MB3hel/AUVControlBoard/docs/docs/user_guide/general_use.md

# Using Control Board

TODO

- General Procedure
    - Connecting to Control Board
    - System configuration (motor matrix, thruster inversions)
    - Sensor configuration
    - Validating sensor connectivity
    - Modes of operation & setting speed
    - Motor Watchdog
    - Reading Sensor data
    - Example program using python interface script
- LED Indicator Info
