MB3hel/AUVControlBoard/docs/docs/user_guide/preparing_board.md

# Preparing a Control Board

TODO:

- Flashing firmware
- Wiring
- Testing USB
