MB3hel/AUVControlBoard/docs/docs/firmware/math_res/construct_orientation_errors.png

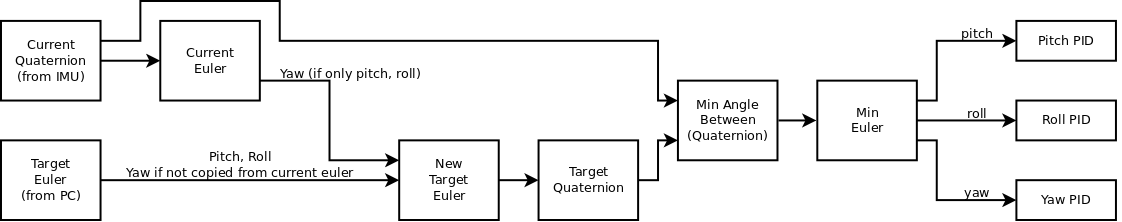
docs/docs/firmware/math_res/construct_orientation_errors.png
