MB3hel/AUVControlBoard/(threads)

Thread 3 (2022-12-10):

Several vars missing static in motor_control

MB3hel, 2022-12-10:
- motor_wdog_timeout function
- Motor wdog timer
- semaphore handle

Closed 2022-12-28.

Thread 8 (2022-12-23):

[FEATURE] Sensor calibration

MB3hel, 2022-12-23:
IMU:

- Ability to calibrate IMU, read calibration registers, store that persistently on a single device, and write the calibration registers on each startup.
- Would also likely need a way to read calibration status of each sensor.
- The BNO055 may be able to save a calibration profile? Need to check datasheet.

Depth sensor:

- Ability to indicate a "surface" reading as "zero" depth. Ideally also could be stored and re-applied on each startup (not on the depth sensor itself, but in firmware).
- Ability to change surface atmospheric pressure and fluid density constants directly

MB3hel, 2023-04-09:
IMU calibration would provide minimal / no benefit for the 6DOF fusion mode used by control board. Thus, only considering depth sensor.

MB3hel, 2023-06-28:
Now WIP on `feature/imucal` branch. Using emulated eeprom to store calibration data (see `feature/emueeprom`).

MB3hel, 2023-06-29:
Fully implemented on `feature/sensorcal`

Closed 2023-06-29.

Thread 10 (2023-01-02):

[FEATURE] Raw IMU data

MB3hel, 2023-01-02:
Add raw BNO055 data read command for debug purposes. Both gyro and accel rates (x, y, z).

MB3hel, 2023-04-09:
No longer planned. Not really any use case. Can just read quaternions to get debug data. Can re-evaluate if a real use case is found.

Closed 2023-04-09.

Thread 12 (2023-01-05):

[BUG] No serial number in usb descriptors for v2

MB3hel, 2023-01-05:
**Describe the bug**
Version 2 has no serial number via USB.

**Tested Versions**
v1, v2

**Impacted Versions**
v2

**To Reproduce**
Connect usb device. Read info. Observe no valid serial number.

**Expected behavior**
Usb would report STM32 chip serial number.

**Additional context**
Serial number for string descriptor not implemented in usb descriptor code for v2.

Closed 2023-01-08.

Thread 13 (2023-01-07):

[BUG] cmdctrl target changes not atomic

MB3hel, 2023-01-07:
cmdctrl can change target when processing pc command, however timer thread is used to re-apply saved speed. Following sequence of operations needs to be impossible (but is not)

- periodic reapply (timer thread) reads the current target
- cmdctrl thread handles a speed set message and changes current target and/or mode
- cmdctrl thread sets new speed
- periodic reapply (timer thread) sets the target it previously read (now wrong target)

Sequence of accessing current mode & saved target speeds then setting speeds needs to be protected by mutex.

Thread 14 (2023-01-14):

[FEATURE] Better failure state behavior

MB3hel, 2023-01-14:
Failure state should write some persistent memory with cause (eg stack overflow) and reset the board instead of just deadlocking forever.

MB3hel, 2023-04-01:
Reset cause is now stored between soft resets on both boards. Can be queried using a command or with interface `whyreset.py` script (`./launch.py whyreset.py -p /dev/ttyACM1`)

Closed 2023-04-01.

Thread 15 (2023-01-15):

[FEATURE REQUEST] Implement watchdog timer

MB3hel, 2023-01-15:
**Is your feature request related to a problem? Please describe.**
Deadlocks can occur in the current firmware (either full deadlocks or single threads blocking forever)

**Describe the solution you'd like**
As a worst case, would be good for board to reset in these cases

Closed 2023-01-27.

Thread 16 (2023-01-15):

[BUG] Command processing fails due to I2C lockup

MB3hel, 2023-01-15:
**Describe the bug**
An I2C lockup is possible on v1 due to some oddities in the hardware state machine for I2C SERCOMs. This lockup results in I2C operations seeming to start correctly, but no interrupt ever occurs indicating a finished operation (no complete, no error, etc). This is a "silent" failure as far as software is concerned.

When this occurs, the i2c perform function will own the mutex and wait for the semaphore, however the semaphore will never be given by the interrupt callback function (as it never happens). This leads to the mutex being held forever.

This often occurs first on the sensor data threads, causing sensor data to stop working. However, an IMU set axis command will cause the cmdctrl thread to attempt an i2c operation. This results in the cmdctrl thread blocking forever.

**Tested Versions**
v1, v2

**Impacted Versions**
v1

**To Reproduce**
Steps to reproduce the behavior (INCLUDE WHAT BUILD CONFIGURATION USED):
1. Run the firmware (debug and release tested)
2. Launch the sensordata interface script
3. Tapidly tap the i2c pins on the BNO055 or the ItsyBitsy with your dry finger (this only accelerates the "failure" but it occurs sometimes without external noise). Repeat until sensor data is not acquired from board anymore (as seen in script output)
4. Kill and re-launch the sensordata script. This causes an imu axis config command
5. Any other commands will timeout since the cmdctrl thread is blocked. A debugger can be used to see the usb thread working properly, but the notification is never serviced (due to thread being blocked).

**Expected behavior**
- I2C "silent failure" should be detected by a timeout waiting for the semaphore. The only way I have found to fix the state is to disable then re-enable the SERCOM
- Waiting on the I2C mutex for i2c_perform should have a timeout. If it times out acquiring the mutex, consider the operation to have failed.
- A watchdog timer should be used to reset the system if cmdctrl can not run for too long (related to #15)

MB3hel, 2023-01-16:
Further investigation indicates that a bus error state may be indicated via the error interrupt when the bad state is entered. Thus, this may be detected without just using a timeout.

Closed 2023-01-16.

Thread 17 (2023-01-15):

[BUG] Sensor data stops being acquired

MB3hel, 2023-01-15:
**Describe the bug**
After some time, sensor data stops being acquired (both I2C sensors).

**Tested Versions**
v1, v2

**Impacted Versions**
v2 (v1 impacted by a different bug with similar effect; see #16)

**To Reproduce**
Steps to reproduce the behavior (INCLUDE WHAT BUILD CONFIGURATION USED):
1. Run the firmware (debug and release tested)
2. Leave it running for a while.
3. See sensor data stop (usually after 30ish minutes)

**Expected behavior**
Sensors don't stop working or if they do, they are recovered.

**Additional context**
I speculate that something happens and a sensor is holding sda low. More investigation is needed using debugger to determine if i2c operations are failing. Scope could also help see if sda is held low.

MB3hel, 2023-01-18:
This is basically the same thing as #16, but the way it impacts v2 is different.

Noise on the bus makes the peripheral thing another device (master) is using the bus. This makes the hardware enter a "BUSY" state (status bit for STM32F4). This usually means another master is using the bus, however there is no other master. Thus if this happens, it should be assumed to be noise (or sensor hotplug) induced. Thus, the firmware needs to recover from this state.

Closed 2023-01-18.

Thread 18 (2023-01-18):

[BUG] Sensor Data is sometimes all zero

MB3hel, 2023-01-18:
**Describe the bug**
Sometimes, when running the `sensordata.py` script, the data is all zeros. Re-launching the script seems to fix the error. This certainly happens with the IMU. I don't recall if it also impacts the depth sensor when this occurs.

My current theory is that the axis configure is somehow related since re-launching the script fixes the issue. That is really the only major config change that re-launching the script would cause.

**Tested Versions**
v1, v2

**Impacted Versions**
v1, v2

**To Reproduce**
Steps to reproduce the behavior (INCLUDE WHAT BUILD CONFIGURATION USED):
1. Build Debug for v1 or v2 (other build configs not tested)
2. Flash the board
3. Run the `sensordata.py` script
4. See if IMU data is all zeros. If not, re-launch sensordata script until it is.

**Expected behavior**
IMU data is not zero

MB3hel, 2023-01-18:
Likely fixed by 771118a5e1df272cff5b6d278051f65121fe0f7c. Will do some more testing and close if no longer reproducible.

MB3hel, 2023-01-27:
Has occurred again despite this change. Other options need to be explored.

MB3hel, 2023-06-29:
This was likely caused by a race condition for using the bno055's i2c_transaction instance. During axis configuration both the cmdctrl thread and the bno055 thread could simultaneously alter the transaction (only the i2c perform was mutexed).

This has been fixed on `feature/sensorcal` and should not be a problem in the next release.

Closed 2023-06-29.

Thread 19 (2023-01-18):

[FEATURE REQUEST] Reset command

MB3hel, 2023-01-18:
**Is your feature request related to a problem? Please describe.**
Some bugs can be worked around by system reset (eg some recent i2c issues). Currently, a power cycle is required.

**Describe the solution you'd like**
Add a command (via USB) to trigger a system reset (likely via watchdog; depends on #15)

**Describe alternatives you've considered**
N/A

**Additional context**
N/A

Closed 2023-01-27.

Thread 20 (2023-02-20):

[BUG] Speed sets on v1 may fail silently

MB3hel, 2023-02-20:
**Describe the bug**
If the `TCCx_PWM24bitDutySet` function returns false, the `thruster_set` function will not retry or do anything about this. In this case, the thruster speed set seems to succeed, but will not have necessarily.

**Tested Versions**
v1

**Impacted Versions**
v1

**Expected behavior**
`thruster_set` should handle this function returning false by retrying the speed set (maybe with a small delay).

**Additional context**

This **could** explain an issue happening AquaPack Java code for using control board missing some speed sets in RAW mode. The testing scenario this occurred in:

- Java code running on Orange Pi 4 LTS
- Java code runs motors one after the other at a fixed speed for a fixed time
- Before each motor is run, a TINV command is sent without waiting for ACK before sending the RAW command
- Control Board v1 unit in use running Release build firmware

The theory is that TINV (triggering an apply_saved_speed) followed by a RAW command already in the buffer may happen fast enough that the PWM set function returns false.

This is consistent with the observations that introducing debug messages into `thruster_set` (debug build) makes this issue no longer occur compared to a release build without any such messages.

The missing of thruster speed sets did not occur every time nor did it occur consistently when it did happen.

This would also explain why the interface scripts work (they do not TINV before RAW so there are not two back to back speed sets happening in the firmware).

TLDR: (theory)

Computer:

- Computer writes TINV (ack not waited for)
- Computer writes RAW (probably at the same time as TINV written due to buffering)
- Control board handles TINV causing a speed set of the saved raw mode target
- Control board handles RAW immediately (already in buffer)
- This causes a second speed set too fast and the pwm set function returns false (not handled)
- Control board acknowledges speed set with no error
- Computer is informed that speeds were set, but some thrusters may not respond sometimes.

Closed 2023-02-21.

Thread 21 (2023-03-27):

[BUG] Reboot to bootloader does not work on v2 with release builds

MB3hel, 2023-03-27:
**Describe the bug**
Triggering a reboot to bootloader using the `reboot_bootoader.py` script works with v2 as expected for debug builds, but fails on release builds.

**Tested Versions**
v1, v2

**Impacted Versions**
v2

**To Reproduce**
1. Build v2 release and flash
2. Run `reboot_bootloader.py` with the correct port
3. The device resets twice, but does not enter bootloader

**Expected behavior**
After the second reset, device should enter bootloader.

Closed 2023-04-01.

Thread 22 (2023-03-31):

[BUG] Reset with newer firmware

MB3hel, 2023-03-31:
**Describe the bug**
- Watchdog triggers system reset unexpectedly when using sassist.py and sensordata.py (release build, v1)
- When using a debug build (debug build, v1) it deadlocks
- Impacts v2 as well (tested with release build, v2 = causes reset)

**Tested Versions**
v1, v2

**Impacted Versions**
v1, v2

**To Reproduce**
1. Build release for v1 or v2
2. Run the `sensordata.py` script
3. Run the `sassist.py` script
4. Wait a few seconds
5. Hit enter to end `sassist.py`
6. Repeat steps 2-5 until the system resets (indicated by LED going back to yellow = RAW mode)

**Expected behavior**
No system reset; deadlock does not occur.

MB3hel, 2023-03-31:
Deadlocks due to `mval` being `nan` causing this to be an infinite loop. Not sure why this becomes nan. Located in `motor_control.c` in `mc_set_local`
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

MB3hel, 2023-03-31:
Caused by check failure in `cmdctrl.c`'s `cmdctrl_apply_saved_speed`. If the IMU data returns zero (as it does after axis configure), this is passed to `mc_set_global`. The newer implementation of `mc_set_global` will result in `nan`s being passed to `mc_set_local` in this scenario due to the invalid quaternion.

This is fixed by checking valid sensor data in `cmdctrl_apply_saved_speed` before calling `mc_set_global`, `mc_set_sassist`, or `mc_set_dhold`

Closed 2023-03-31.

Thread 23 (2023-04-09):

[FEATURE] Change Sensor models to names in messages

MB3hel, 2023-04-09:
BNO055 -> IMU
MS5837 -> DEPTH

MB3hel, 2023-06-29:
Given the existing stable release, there are no longer plans to do this.

Closed 2023-06-29.

Thread 24 (2023-04-10):

[BUG] Sending commands too fast crashes control board

MB3hel, 2023-04-10:
**Describe the bug**
Sending SASSIST1 messages too fast will cause the control board to deadlock and a watchdog reset to occur.

**Tested Versions**
v1, v2

**Impacted Versions**
v1, v2

**To Reproduce**
1. Flash Release Build (v1) (also impacts debug builds, but does not cause reset since WDT disabled for debug)
2. Send SASSIST1 messages as fast as possible (don't wait for ACK)
3. Wait until serial communication drops
4. Check reset cause using `./launch.py whyreset`. It will be `-6`.

**Expected behavior**
No deadlock or reset occurs

MB3hel, 2023-04-10:
Note that sometimes it is required to disable waiting for ACK on SASSIST1 messages to reproduce this.

MB3hel, 2023-04-10:
Can also be reproduced using python interface, which does wait for acknowledgement

`test.py`
```py
#!/usr/bin/env python3

from control_board import ControlBoard, Simulator
import random
import time

def run(cb: ControlBoard, s: Simulator) -> int:
    res, imu, depth = cb.get_sensor_status()
    if(res == cb.AckError.NONE):
        print("Done")
    else:
        print("Fail")
        return 1
    if imu == False or depth == False:
        print("Missing sensor(s).")
        return 1
    cb.tune_sassist_pitch(4.0, 0.0, 0.0, 1.0, False)
    cb.tune_sassist_roll(4.0, 0.0, 0.0, 1.0, False)
    cb.tune_sassist_yaw(4.0, 0.0, 0.0, 1.0, False)
    cb.tune_sassist_depth(4.0, 0.0, 0.0, 1.0, False)
    while True:
        depth = random.randint(-100, -1)
        depth /= 10.0
        cb.set_sassist1(0.0, 0.0, 0.0, 0.0, 0.0, depth)
```

MB3hel, 2023-04-10:
From debug build (which takes much longer to trigger the issue), it seems to end up on line 168 of `thirdparty/FreeRTOS/list.c`. This has a lovely note...

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

And the following call stack
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

MB3hel, 2023-04-10:
This can also be triggered with a global mode set or local mode set. Also with non-speed set commands such as sensor status queries.

MB3hel, 2023-04-10:
Seems to be caused by use of critical section in `pccomm_write`. Replaced with mutex. On `fix_fast_msg` branch.

Closed 2023-04-10.

Thread 26 (2023-04-19):

[FEATURE] Accumulated euler angles in sim hijack without BNO055

MB3hel, 2023-04-19:
Simulator hijack without a BNO055 doesn't accumulate euler angles. Would probably be best to split BNO055 and MS5837 data processing (`sensor_process(data...)`). The read function would call process. Cmdctrl would call process when receiving sim data.

MB3hel, 2023-05-12:
Fixed differently.

Thread 27 (2023-06-11):

[BUG] Incorrect Motor Motions after running for a long time

MB3hel, 2023-06-11:
**Describe the bug**
After leaving the device running for several hours (somewhere between 2-5 hours) the control board started generating incorrect motor signals. During the several hours the device was running, various commands were sent to the device and the vehicle was in motion using various modes.

When the issue occurred, thrusters would not complete arming (usually; sometimes a few would). This was determined by the last "beep" that indicates a zero speed is currently applied to the ESC by PWM signal. Additionally, when trying to run a motor test, various unexpected motions occurred (details of what specific motions were are unknown).

**Tested Versions**
v1

**Impacted Versions**
v1

**To Reproduce**
1. Run for a long time
2. Check PWM signals
3. Observe any issues

**Expected behavior**
1500us pulse for zero speed

MB3hel, 2023-06-28:
I have been unable to reproduce this as of now. More info is needed to track down this issue.

Thread 28 (2023-11-07):

[BUG] Crash on NaN Motor Speeds

Bennett-Petzold, 2023-11-07:
**Describe the bug**
Sending NaN as a motor speed causes a reset with code -6.

**Tested Versions**
v1 and v2

**Impacted Versions**
v1 and v2

**To Reproduce**
Send a stability_assist_2 command with a NaN as the x value.

**Expected behavior**
Some non-crash behavior, likely a rejection of the message.

**Additional context**
The code crashes because it gets stuck in a loop.

MB3hel, 2023-11-25:
Now fixed on main. Will be in next 1.1.0 release.

When sending nan, inf, or other out of range values, the command is **not** rejected. The control board fores values into the valid range for arguments. In the case of nan or inf, they will be treated as zeros. This is consistent with the behavior described in the docs.

While it may be useful in this specific case to have out of range values be rejected with an "INVALID_ARG" error, this error is primarily intended to mean "incorrect number of arguments". Furthermore, rejecting out of range value with INVALID_ARG could cause other problems. For example, if the code sending speeds to the control board calculates 1.05 instead of 1.00 due to floating point errors, it would be undesirable for control board to reject the command. As such, out of range values are (by design) forced into range by the control board.

It is recommended to have value checks (for nan, inf, values with magnitudes much larger than 1, etc) in code using the control board (the code issuing commands). This can allow warnings to be logged if invalid values are generated before sending to the control board.

Closed 2023-11-25.
