MB3hel/AUVControlBoard/pcb/PCBv2.1/PCBv2.1.kicad_sch

## KiCad design pcb/PCBv2.1/PCBv2.1.kicad_sch (2023-04-08, an earlier design)

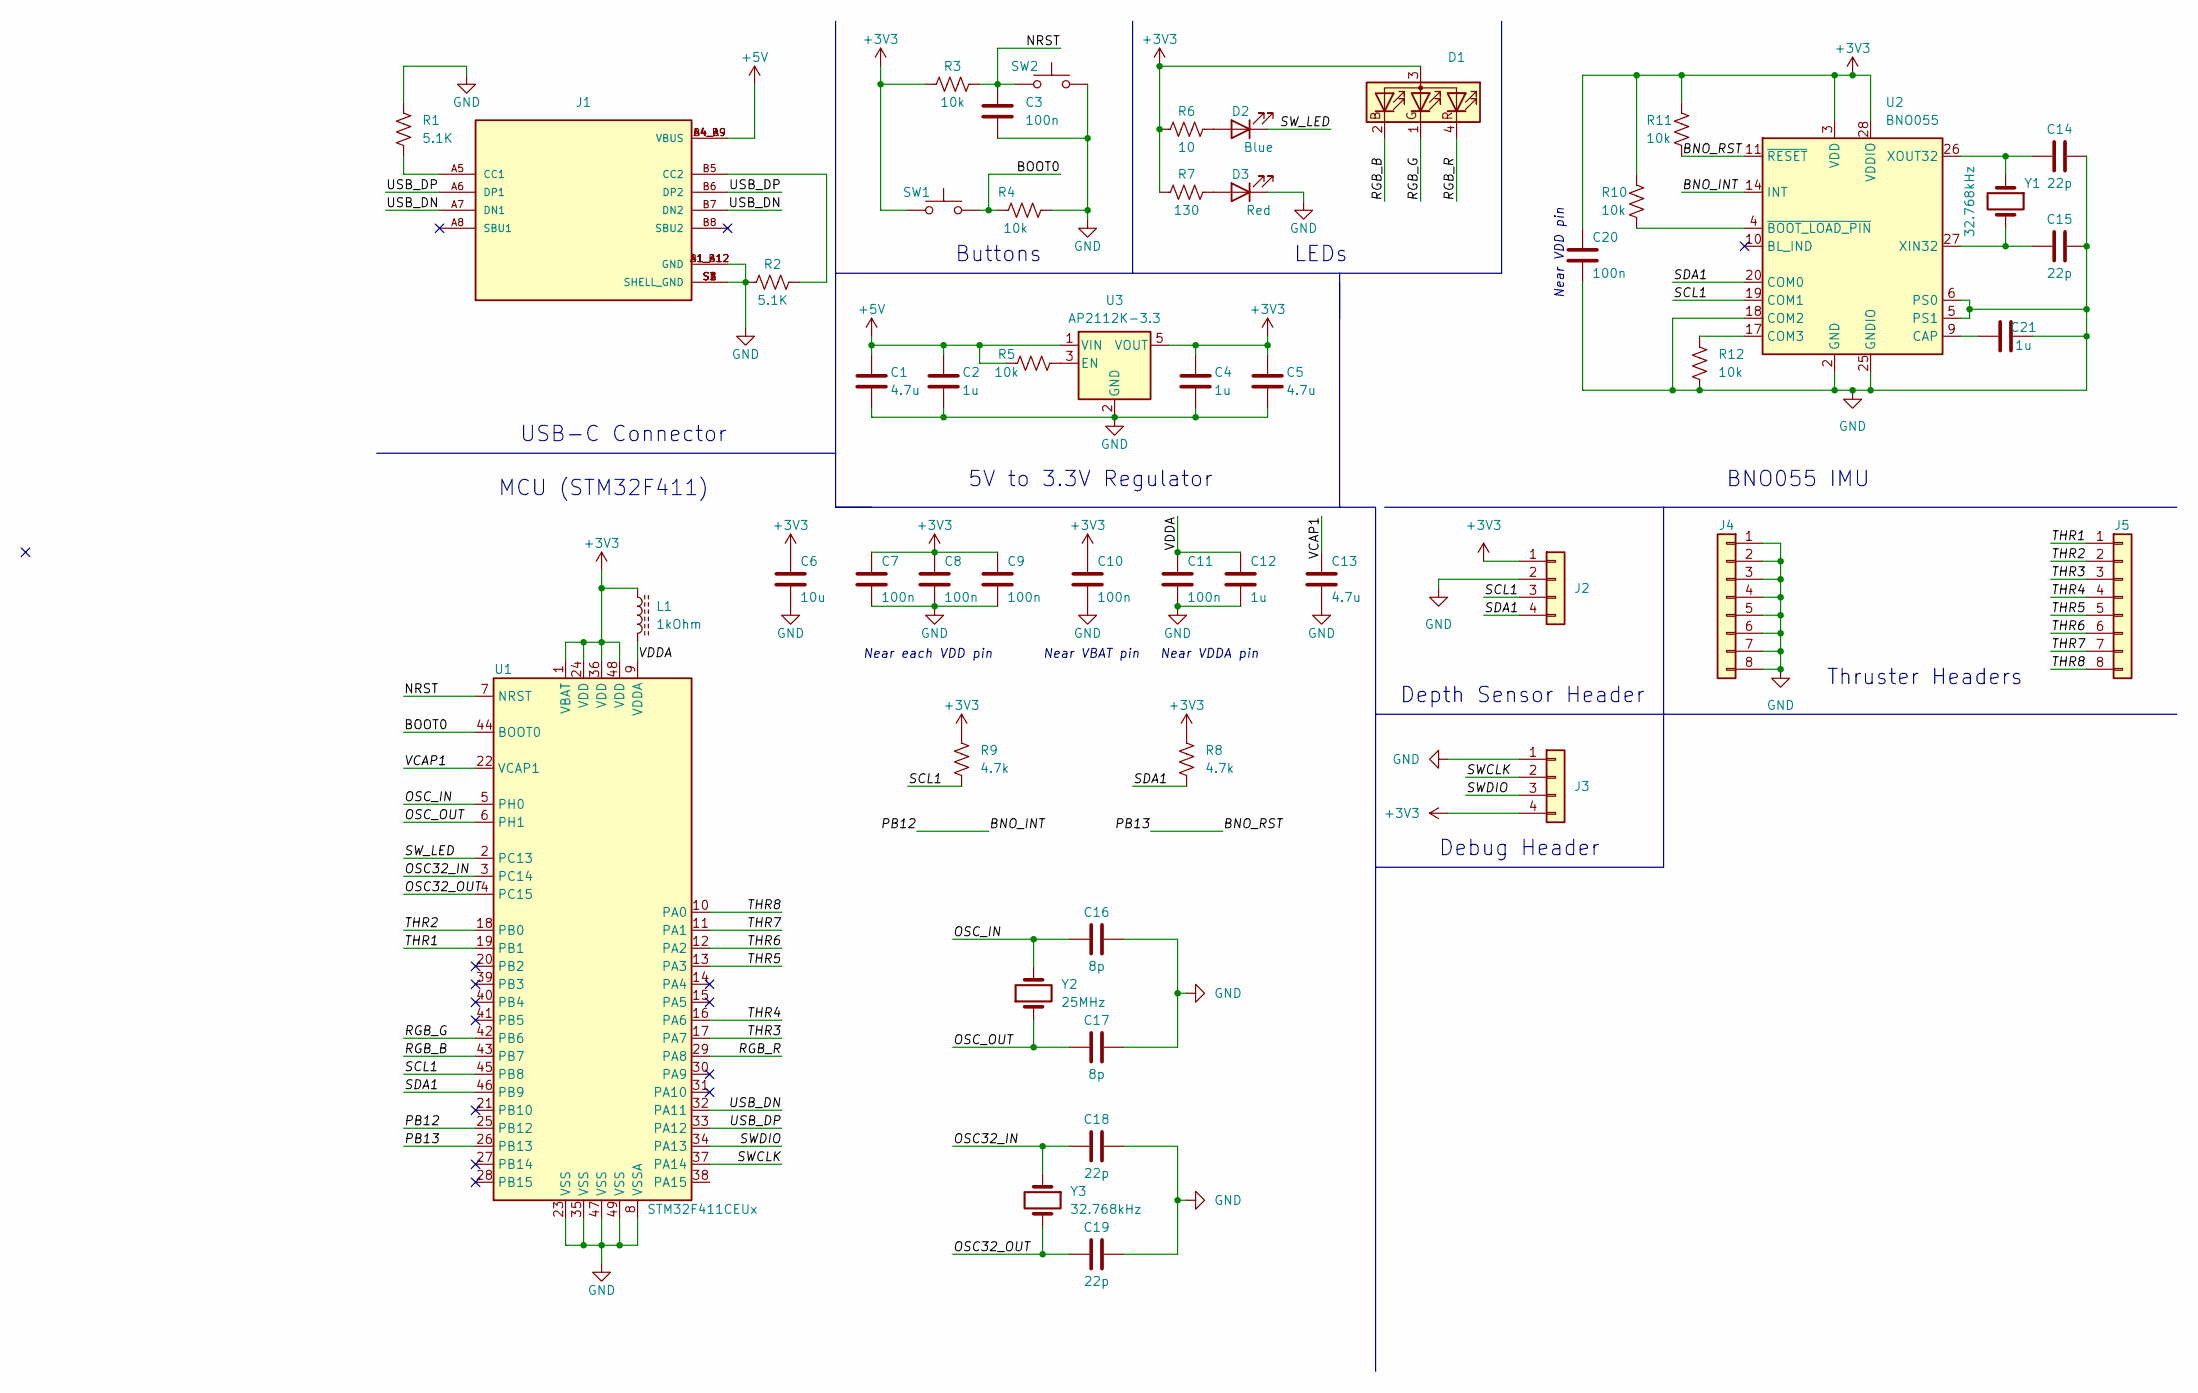
[picture p31: schematic PCBv2.1.kicad_sch]

Parts:
C1, C5, C13: 4.7u; C_0805_2012Metric_Pad1.18x1.45mm_HandSolder; Part Number GRM21BC71E475KE11L
C2, C4, C12, C21: 1u; C_0805_2012Metric_Pad1.18x1.45mm_HandSolder; Part Number GCJ21BC72A105KE02L
C3, C7, C8, C9, C10, C11, C20: 100n; C_0805_2012Metric_Pad1.18x1.45mm_HandSolder; Part Number GCM21BR71E104JA37L
C6: 10u; C_0805_2012Metric_Pad1.18x1.45mm_HandSolder; Part Number GRT21BC71E106KE13L
C14, C15, C18, C19: 22p; C_0805_2012Metric_Pad1.18x1.45mm_HandSolder; Part Number GRM21A5C2E220FW01D
C16, C17: 8p; C_0805_2012Metric_Pad1.18x1.45mm_HandSolder; Part Number GQM2195C2E8R0CB12D
D1: LED_RGBA; LED_D5.0mm-4_RGB; Part Number QBL8RGB60D0-2897
D2: Blue; LED_0805_2012Metric_Pad1.15x1.40mm_HandSolder; Part Number 150080BS75000
D3: Red; LED_0805_2012Metric_Pad1.15x1.40mm_HandSolder; Part Number 150080RS75000
J1: USB4105-GF-A; GCT_USB4105-GF-A; Part Number USB4105-GF-A
J2, J3: Conn_01x04; PinHeader_1x04_P2.54mm_Vertical
J4, J5: Conn_01x08; PinHeader_1x08_P2.54mm_Vertical
L1: 1kOhm; L_0805_2012Metric_Pad1.05x1.20mm_HandSolder; Part Number MFBM1V2012-102-R
R1, R2: 5.1K; R_0805_2012Metric_Pad1.20x1.40mm_HandSolder; Part Number ERJ-HP6F5101V
R3, R4, R5, R10, R11, R12: 10k; R_0805_2012Metric_Pad1.20x1.40mm_HandSolder; Part Number ERJ-6ENF1002V
R6: 10; R_0805_2012Metric_Pad1.20x1.40mm_HandSolder; Part Number ERJ-6ENF10R0V
R7: 130; R_0805_2012Metric_Pad1.20x1.40mm_HandSolder; Part Number ERJ-P06F1300V
R8, R9: 4.7k; R_0805_2012Metric_Pad1.20x1.40mm_HandSolder; Part Number ERJ-6ENF4701V
SW1, SW2: SW_Push
U1: STM32F411CEUx; QFN-48-1EP_7x7mm_P0.5mm_EP5.6x5.6mm; Part Number STM32F411CEU6
U2: BNO055; LGA-28_5.2x3.8mm_P0.5mm; Part Number BNO055
U3: AP2112K-3.3; SOT-23-5; Part Number AP2112K-3.3
Y1, Y3: 32.768kHz; Part Number ABS25-32.768KHZ-T
Y2: 25MHz; Part Number NX2016SA-25.000M-STD-CZS-1

Connections:
+3V3: C4.1, C5.1, C6.1, C7.1, C8.1, C9.1, C10.1, C20.1, D1.3 (A), J2.1, J3.4, L1.1, R3.1, R6.1, R7.1, R8.1, R9.1, R10.1, R11.1, SW1.1, U1.1 (VBAT), U1.24 (VDD), U1.36 (VDD), U1.48 (VDD), U2.3 (VDD), U2.28 (VDDIO), U3.5 (VOUT)
+5V: C1.1, C2.1, J1.A4_B9 (VBUS), J1.B4_A9 (VBUS), R5.1, U3.1 (VIN)
BNO_INT: U1.25 (PB12), U2.14 (INT)
BNO_RST: R11.2, U1.26 (PB13), U2.11 (~RESET)
BOOT0: R4.1, SW1.2, U1.44 (BOOT0)
GND: C1.2, C2.2, C3.2, C4.2, C5.2, C6.2, C7.2, C8.2, C9.2, C10.2, C11.2, C12.2, C13.2, C14.2, C15.2, C16.2, C17.2, C18.2, C19.2, C20.2, C21.2, D3.1 (K), J1.A1_B12 (GND), J1.B1_A12 (GND), J1.S1 (SHELL_GND), J1.S2 (SHELL_GND), J1.S3 (SHELL_GND), J1.S4 (SHELL_GND), J2.2, J3.1, J4.1, J4.2, J4.3, J4.4, J4.5, J4.6, J4.7, J4.8, R1.1, R2.1, R4.2, R12.2, SW2.2, U1.8 (VSSA), U1.23 (VSS), U1.35 (VSS), U1.47 (VSS), U1.49 (VSS), U2.2 (GND), U2.5 (PS1), U2.6 (PS0), U2.15 (GNDIO), U2.16 (GNDIO), U2.18 (COM2), U2.25 (GNDIO), U3.2 (GND)
NRST: C3.1, R3.2, SW2.1, U1.7 (NRST)
unnamed: C14.1, U2.26 (XOUT32), Y1.1
unnamed: C15.1, U2.27 (XIN32), Y1.2
unnamed: C21.1, U2.9 (CAP)
unnamed: D2.2 (A), R6.2
unnamed: D3.2 (A), R7.2
unnamed: J1.A5 (CC1), R1.2
unnamed: J1.B5 (CC2), R2.2
unnamed: R5.2, U3.3 (EN)
unnamed: R10.2, U2.4 (~BOOT_LOAD_PIN)
unnamed: R12.1, U2.17 (COM3)
OSC32_IN: C18.1, U1.3 (PC14), Y3.1
OSC32_OUT: C19.1, U1.4 (PC15), Y3.2
OSC_IN: C16.1, U1.5 (PH0), Y2.2
OSC_OUT: C17.1, U1.6 (PH1), Y2.1
RGB_B: D1.2 (BK), U1.43 (PB7)
RGB_G: D1.1 (GK), U1.42 (PB6)
RGB_R: D1.4 (RK), U1.29 (PA8)
SCL1: J2.3, R9.2, U1.45 (PB8), U2.19 (COM1)
SDA1: J2.4, R8.2, U1.46 (PB9), U2.20 (COM0)
SWCLK: J3.2, U1.37 (PA14)
SWDIO: J3.3, U1.34 (PA13)
SW_LED: D2.1 (K), U1.2 (PC13)
THR1: J5.1, U1.19 (PB1)
THR2: J5.2, U1.18 (PB0)
THR3: J5.3, U1.17 (PA7)
THR4: J5.4, U1.16 (PA6)
THR5: J5.5, U1.13 (PA3)
THR6: J5.6, U1.12 (PA2)
THR7: J5.7, U1.11 (PA1)
THR8: J5.8, U1.10 (PA0)
USB_DN: J1.A7 (DN1), J1.B7 (DN2), U1.32 (PA11)
USB_DP: J1.A6 (DP1), J1.B6 (DP2), U1.33 (PA12)
VCAP1: C13.1, U1.22 (VCAP1)
VDDA: C11.1, C12.1, L1.2, U1.9 (VDDA)

Notes on the sheet:
Debug Header
BNO055 IMU
Near each VDD pin
LEDs
USB-C Connector
Buttons
Depth Sensor Header
Thruster Headers
MCU (STM32F411)
Near VDDA pin
Near VBAT pin
5V to 3.3V Regulator
Near VDD pin
