MB3hel/AUVControlBoard/firmware/src/main.c

/*
 * Copyright 2022 Marcus Behel
 * 
 * This file is part of AUVControlBoard-Firmware.
 * 
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
 */

#include <framework.h>
#include <FreeRTOS.h>
#include <task.h>
#include <led.h>
#include <delay.h>
#include <math.h>
#include <usb.h>
#include <thruster.h>
#include <app.h>
#include <cmdctrl.h>
#include <conversions.h>
#include <motor_control.h>
#include <i2c.h>
#include <wdt.h>
#include <debug.h>


#if defined(CONTROL_BOARD_V1)
__attribute__((section(".noinit"))) volatile uint32_t first_run;
__attribute__((section(".noinit"))) volatile uint32_t reset_cause_persist;
#endif


////////////////////////////////////////////////////////////////////////////////////////////////////////////////////////
/// Program Entry point / startup
////////////////////////////////////////////////////////////////////////////////////////////////////////////////////////

int main(void){
    // -------------------------------------------------------------------------
    // System & Peripheral Initialization
    // -------------------------------------------------------------------------
    init_frameworks();
    conversions_init();

#ifdef NDEBUG
    // Enable watchdog if not debug build
    wdt_init();
#endif

    delay_init();
    led_init();
    usb_init();
    thruster_init();
    mc_init();
    cmdctrl_init();
    i2c_init();
    // -------------------------------------------------------------------------
    
    app_init();

    // -------------------------------------------------------------------------
    // RTOS Startup
    // -------------------------------------------------------------------------
    vTaskStartScheduler();
    // -------------------------------------------------------------------------

    // Start scheduler should never return. This should never run, but is
    // included to make debugging easier in case it does
    debug_halt(HALT_EC_SCHEDRET);
}
////////////////////////////////////////////////////////////////////////////////////////////////////////////////////////
