MB3hel/AUVControlBoard/firmware/generator_projects/ControlBoard_v2/ControlBoard_v2.ioc

Mcu.UserName=STM32F411CEUx
PA0-WKUP.GPIO_Label=THR8
PA0-WKUP.Signal=S_TIM5_CH1
PA1.GPIO_Label=THR7
PA1.Signal=S_TIM5_CH2
PA10.Signal=USB_OTG_FS_ID
PA11.Signal=USB_OTG_FS_DM
PA12.Signal=USB_OTG_FS_DP
PA2.GPIO_Label=THR6
PA2.Signal=S_TIM5_CH3
PA3.GPIO_Label=THR5
PA3.Signal=S_TIM5_CH4
PA6.GPIO_Label=THR4
PA6.Signal=S_TIM3_CH1
PA7.GPIO_Label=THR3
PA7.Signal=S_TIM3_CH2
PA8.GPIO_Label=RGBLED_R
PA8.Signal=S_TIM1_CH1
PA9.Signal=USB_OTG_FS_VBUS
PB0.GPIO_Label=THR2
PB0.Signal=S_TIM3_CH3
PB1.GPIO_Label=THR1
PB1.Signal=S_TIM3_CH4
PB6.GPIO_Label=RGBLED_G
PB6.Signal=S_TIM4_CH1
PB7.GPIO_Label=RGBLED_B
PB7.Signal=S_TIM4_CH2
PB8.Signal=I2C1_SCL
PB9.Signal=I2C1_SDA
PC13-ANTI_TAMP.GPIO_Label=BLUE_LED
PC13-ANTI_TAMP.Signal=GPIO_Output
PC14-OSC32_IN.Signal=RCC_OSC32_IN
PC15-OSC32_OUT.Signal=RCC_OSC32_OUT
