MB3hel/AUVControlBoard/iface/gamepad_global.py

#!/usr/bin/env python3
# Intended to run on a SBC on the robot with control board connected
# Receives gamepad data over UDP (using protocol of ArPiRobot-DriveStation)
# Moves using vectored motion based on gamepad data

import math
import struct
import threading
import signal
import traceback
from typing import Dict, List
import time
import socket
import atexit
from control_board import ControlBoard, Simulator


class Gamepad:
    __instances: Dict[int, 'Gamepad'] = {}
    __instance_lock = threading.Lock()

    @staticmethod
    def get(num: int):
        with Gamepad.__instance_lock:
            if num in Gamepad.__instances:
                return Gamepad.__instances[num]
            Gamepad.__instances[num] = Gamepad()
            return Gamepad.__instances[num]

    def __init__(self):
        self.__axes: List[float] = []
        self.__btns: List[bool] = []
        self.__dpads: List[int] = []
        self.__data_lock = threading.Lock()
        self.__update_time = 0
    
    def update_data(self, data: bytes):
        with self.__data_lock:
            num = data[0]
            axis_count = data[1]
            btn_count = data[2]
            dpad_count = data[3]
            if len(self.__axes) != axis_count:
                self.__axes.clear()
                self.__axes.extend([0.0] * axis_count)
            if len(self.__btns) != btn_count:
                self.__btns.clear()
                self.__btns.extend([False] * btn_count)
            if len(self.__dpads) != dpad_count:
                self.__dpads.clear()
                self.__dpads.extend([0] * dpad_count)
            
            # Each axis is signed 16-bit integer (full range)\
            offset = 4
            for i in range(axis_count):
                tmp = struct.unpack(">h", data[offset:offset+2])[0]
                if tmp <= 0:
                    self.__axes[i] = tmp / 32768.0
                else:
                    self.__axes[i] = tmp / 32767.0
                offset += 2

            # Each byte encodes 8 button states
            for i in range(math.ceil(btn_count / 8.0) - 1, -1, -1):
                b = data[4 + (2 * axis_count) + i]
                for j in range(7, -1, -1):
                    if(i * 8 + j) < btn_count:
                        self.__btns[i * 8 + j] = ( (b & 0x01) == 1)
                    b >>= 1
            
            # Each byte encodes 2 dpads (int between 0 and 8)
            for i in range(math.ceil(dpad_count / 2.0) - 1, -1, -1):
                b = data[4 + (2 * axis_count) + math.ceil(btn_count / 8.0) + i]
                for j in range(1, -1, -1):
                    if (i * 2 + j) < dpad_count:
                        self.__dpads[i * 2 + j] = (b & 0x0F)
                    b >>= 4

            self.__update_time = time.time()

    def get_axis(self, axis: int, deadband = 0) -> float:
        with self.__data_lock:
            if time.time() - self.__update_time > 1:
                return 0.0
            if axis < len(self.__axes):
                v = self.__axes[axis]
                if abs(v) < deadband:
                    return 0.0
                else:
                    return (v - (abs(v) / v * deadband)) / (1 - deadband)
            return 0.0
    
    def get_button(self, btn: int) -> bool:
        with self.__data_lock:
            if time.time() - self.__update_time > 1:
                return False
            if btn < len(self.__btns):
                return self.__btns[btn]
            return False
    
    def get_dpad(self, dpad: int) -> int:
        with self.__data_lock:
            if time.time() - self.__update_time > 1:
                return 0
            if dpad < len(self.__dpads):
                return self.__dpads[dpad]
            return 0


class NetMgr:
    def __init__(self):
        self.__controller_sock = socket.socket(socket.AF_INET, socket.SOCK_DGRAM)
        self.__cmd_sock = socket.socket(socket.AF_INET, socket.SOCK_STREAM)
        self.__ntb_sock = socket.socket(socket.AF_INET, socket.SOCK_STREAM)
        self.__log_sock = socket.socket(socket.AF_INET, socket.SOCK_STREAM)
        self.__controller_sock.setsockopt(socket.SOL_SOCKET, socket.SO_REUSEADDR, 1)
        self.__controller_sock.bind(("0.0.0.0", 8090))
        self.__cmd_sock.setsockopt(socket.SOL_SOCKET, socket.SO_REUSEADDR, 1)
        self.__cmd_sock.bind(("0.0.0.0", 8091))
        self.__cmd_sock.listen()
        self.__ntb_sock.setsockopt(socket.SOL_SOCKET, socket.SO_REUSEADDR, 1)
        self.__ntb_sock.bind(("0.0.0.0", 8092))
        self.__ntb_sock.listen()
        self.__log_sock.setsockopt(socket.SOL_SOCKET, socket.SO_REUSEADDR, 1)
        self.__log_sock.bind(("0.0.0.0", 8093))
        self.__log_sock.listen()
        self.__crl_t = threading.Thread(target=self.__run_controller, daemon=True)
        self.__cmd_t = threading.Thread(target=self.__run, daemon=True, args=(self.__cmd_sock,))
        self.__ntb_t = threading.Thread(target=self.__run, daemon=True, args=(self.__ntb_sock,))
        self.__log_t = threading.Thread(target=self.__run, daemon=True, args=(self.__log_sock,))
        self.__crl_t.start()
        self.__cmd_t.start()
        self.__ntb_t.start()
        self.__log_t.start()

    
    def __run(self, sock: socket.socket):
        clients = []
        while True:
            conn, _ = sock.accept()
            clients.append(conn)
    
    def __run_controller(self):
        while True:
            data, _ = self.__controller_sock.recvfrom(1024)
            cnum = data[0]
            g = Gamepad.get(cnum)
            try:
                g.update_data(data)
            except:
                traceback.print_exc()
                # Not enough data, parsing failed
                print("PARSE FAIL")
                pass
    
    def __del__(self):
        self.__cmd_sock.close()
        self.__ntb_sock.close()
        self.__log_sock.close()
        self.__controller_sock.close()


def run(cb: ControlBoard, s: Simulator) -> int:
    ############################################################################
    # Setup
    ############################################################################
    if s is None:
        # Can only do this if not in simulation
        print("Set motor matrix...", end="")
        mat = ControlBoard.MotorMatrix()
        #        MotorNum    x      y      z    pitch   roll     yaw
        mat.set_row(3,    [ -1,    -1,     0,     0,      0,     +1   ])
        mat.set_row(4,    [ +1,    -1,     0,     0,      0,     -1   ])
        mat.set_row(1,    [ -1,    +1,     0,     0,      0,     -1   ])
        mat.set_row(2,    [ +1,    +1,     0,     0,      0,     +1   ])
        mat.set_row(7,    [  0,     0,    -1,    -1,     -1,      0   ])
        mat.set_row(8,    [  0,     0,    -1,    -1,     +1,      0   ])
        mat.set_row(5,    [  0,     0,    -1,    +1,     -1,      0   ])
        mat.set_row(6,    [  0,     0,    -1,    +1,     +1,      0   ])
        if cb.set_motor_matrix(mat) == ControlBoard.AckError.NONE:
            print("Done.")
        else:
            print("Fail.")
            return 1

        print("Set thruster inversions...", end="")
        if cb.set_tinv([True, True, False, False, True, False, False, True]) == ControlBoard.AckError.NONE:
            print("Done.")
        else:
            print("Fail.")
            return 1

    
    ############################################################################
    # Network startup
    ############################################################################
    netmgr = NetMgr()
    gp0 = Gamepad.get(0)


    ############################################################################
    # Main loop
    ############################################################################
    print("Enter main loop")
    try:
        while True:
            # Left stick x and y = strafe
            # Left trigger = yaw ccw
            # Right trigger = yaw cw
            # Dpad up / down = surface / submerge
            # Right stick x = roll
            # Right stick y = pitch
            x = gp0.get_axis(0, 0.1)
            y = gp0.get_axis(1, 0.1)
            roll = gp0.get_axis(2, 0.1)
            pitch = gp0.get_axis(3, 0.1)
            yawccw = gp0.get_axis(4, 0.1)
            yawcw = gp0.get_axis(5, 0.1)
            yaw = (yawccw - yawcw)
            dpad = gp0.get_dpad(0)
            if dpad == 8 or dpad == 1 or dpad == 2:
                z = 1.0
            elif dpad == 6 or dpad == 5 or dpad == 4:
                z = -1.0
            else:
                z = 0.0

            # Scale speeds to make the robot more controllable
            x *= 0.5
            y *= -0.5
            yaw *= 0.45
            pitch *= 0.7
            roll *= 0.2
            z *= 0.5

            # Set the speeds
            # Note that speed updates feed motor watchdog
            # This happens often enough that it is unnecessary to explicitly feed watchdog
            cb.set_global(x, y, z, pitch, roll, yaw)
            time.sleep(0.02)
    except (KeyboardInterrupt, Exception) as e:
        cb.set_global(0.0, 0.0, 0.0, 0.0, 0.0, 0.0)
        old_handler = signal.getsignal(signal.SIGINT)
        signal.signal(signal.SIGINT, dummy_handler)
        del netmgr
        signal.signal(signal.SIGINT, old_handler)
        if not isinstance(e, KeyboardInterrupt):
            raise e


def dummy_handler(signum, frame):
    # Used temporarily suppress ctrl-c
    pass
