MB3hel/AUVControlBoard/firmware/src/ports.c

/**
 * @file ports.c
 * @author Marcus Behel
 */

#include <ports.h>
#include <clocks.h>
#include <sam.h>
#include <ms5837.h>


void ports_pinfunc(uint8_t def, int8_t pinfunc){
    uint8_t port = PORT_GETPORT(def);
    uint8_t pin = PORT_GETPIN(def);
    if(pinfunc == PORT_PINFUNC_GPIO){
        PORT->Group[port].PINCFG[pin].bit.PMUXEN = 0;
    }else{
        PORT->Group[port].PINCFG[pin].bit.PMUXEN = 1;
        if(PORT_GETPIN(def) & 0x1){
            // Odd pin (pmux group pin / 2 = pin >> 1)
            PORT->Group[port].PMUX[pin >> 1].bit.PMUXO = pinfunc;
        }else{
            // Even pin (pmux group pin / 2 = pin >> 1)
            PORT->Group[port].PMUX[pin >> 1].bit.PMUXE = pinfunc;
        }
    }
}

void ports_gpio_dir(uint8_t def, uint8_t dir){
    uint8_t port = PORT_GETPORT(def);
    uint8_t pin = PORT_GETPIN(def);
    if(dir == 0){
        // Input pin
        PORT->Group[port].DIRCLR.reg = 0x1 << pin;
    }else{
        // Output pin
        PORT->Group[port].DIRSET.reg = 0x1 << pin;
    }
    // In both modes, enable input (allows reading OUT pin too)
    PORT->Group[port].PINCFG[pin].bit.INEN = 1;
}

void ports_gpio_pull(uint8_t def, uint8_t pull){
    uint8_t port = PORT_GETPORT(def);
    uint8_t pin = PORT_GETPIN(def);
    switch(pull){
    case PORT_GPIO_PULLOFF:
        PORT->Group[port].PINCFG[pin].bit.PULLEN = 0;
        break;
    case PORT_GPIO_PULLUP:
        PORT->Group[port].PINCFG[pin].bit.PULLEN = 1;
        PORT->Group[port].OUTSET.reg = 0x1 << pin;
        break;
    case PORT_GPIO_PULLDOWN:
        PORT->Group[port].PINCFG[pin].bit.PULLEN = 1;
        PORT->Group[port].OUTCLR.reg = 0x1 << pin;
        break;
    }
}

void ports_gpio_write(uint8_t def, uint8_t out){
    uint8_t port = PORT_GETPORT(def);
    uint8_t pin = PORT_GETPIN(def);
    if(out){
        PORT->Group[port].OUTSET.reg = 0x1 << pin;
    }else{
        PORT->Group[port].OUTCLR.reg = 0x1 << pin;
    }
}

void ports_gpio_set(uint8_t def){
    uint8_t port = PORT_GETPORT(def);
    uint8_t pin = PORT_GETPIN(def);
    PORT->Group[port].OUTSET.reg = 0x1 << pin;
}

void ports_gpio_clear(uint8_t def){
    uint8_t port = PORT_GETPORT(def);
    uint8_t pin = PORT_GETPIN(def);
    PORT->Group[port].OUTCLR.reg = 0x1 << pin;
}

void ports_gpio_toggle(uint8_t def){
    uint8_t port = PORT_GETPORT(def);
    uint8_t pin = PORT_GETPIN(def);
    PORT->Group[port].OUTTGL.reg = 0x1 << pin;
}

uint8_t ports_gpio_read(uint8_t def){
    uint8_t port = PORT_GETPORT(def);
    uint8_t pin = PORT_GETPIN(def);
    return (PORT->Group[port].IN.reg & (0x1 << pin)) >> pin;
}

void ports_init(void){
    // Dotstar CLK pin
    ports_pinfunc(P_DS_CLK, PORT_PINFUNC_GPIO);
    ports_gpio_dir(P_DS_CLK, PORT_GPIO_OUT);
    ports_gpio_clear(P_DS_CLK);

    // Dotstar DAT pin
    ports_pinfunc(P_DS_DAT, PORT_PINFUNC_GPIO);
    ports_gpio_dir(P_DS_DAT, PORT_GPIO_OUT);
    ports_gpio_clear(P_DS_DAT);

    // USB DM pin
    ports_pinfunc(P_USB_DM, MUX_PA24H_USB_DM);    

    // USB DP pin
    ports_pinfunc(P_USB_DP, MUX_PA25H_USB_DP);

    // Thruster PWM pins
    ports_pinfunc(P_THR1_PWM, MUX_PA22G_TCC0_WO2);
    ports_pinfunc(P_THR2_PWM, MUX_PA23G_TCC0_WO3);
    ports_pinfunc(P_THR3_PWM, MUX_PA21G_TCC0_WO1);
    ports_pinfunc(P_THR4_PWM, MUX_PA20G_TCC0_WO0);
    ports_pinfunc(P_THR5_PWM, MUX_PA19F_TCC1_WO3);
    ports_pinfunc(P_THR6_PWM, MUX_PA18F_TCC1_WO2);
    ports_pinfunc(P_THR7_PWM, MUX_PA17F_TCC1_WO1);
    ports_pinfunc(P_THR8_PWM, MUX_PA16F_TCC1_WO0);

    // I2C0 pins
    ports_pinfunc(P_I2C0_SDA, MUX_PA12C_SERCOM2_PAD0);
    ports_pinfunc(P_I2C0_SCL, MUX_PA13C_SERCOM2_PAD1);
}

void ports_i2c0_fix_sda_low(void){
    // Sometimes, a sensor may be holding SDA low when MCU is reset
    // In this case, I2C can't init properly
    // To fix this, send clock pulses until SDA released

    // Not that for I2C there are pullup resistors on each line
    // Thus, lines should be driven low (outputs), but when they should go
    // high they should be left floating as inputs. Additionally, slaves
    // can stretch the clock. This means the slaves (sensors) may hold the line
    // low after the master releases the line. Thust, the master must wait for
    // the salve to release the line allowing it to float high.

    // Temporarily put pins in GPIO mode (bitbang the clock)
    // Delay of 10us = 100000kHz data rate = max for I2C standard mode
    ports_pinfunc(P_I2C0_SDA, PORT_PINFUNC_GPIO);
    ports_pinfunc(P_I2C0_SCL, PORT_PINFUNC_GPIO);
    ports_gpio_dir(P_I2C0_SDA, PORT_GPIO_IN);
    ports_gpio_dir(P_I2C0_SCL, PORT_GPIO_IN);
    ports_gpio_pull(P_I2C0_SCL, PORT_GPIO_PULLOFF);
    ports_gpio_pull(P_I2C0_SDA, PORT_GPIO_PULLOFF);

    // Send clock pulses until the SDA line is released
    // Max of 100 clock cycles. If it doesn't work after 100 cycles
    // it isn't going to. Let i2c transactions fail due to timeout.
    uint32_t attempts = 0;
    while(ports_gpio_read(P_I2C0_SDA) == PORT_GPIO_LOW){
        if(attempts++ >= 100)
            break;

        // Drive clock low
        ports_gpio_dir(P_I2C0_SCL, PORT_GPIO_OUT);
        ports_gpio_clear(P_I2C0_SCL);
        delay_us(10);

        // Let clock float high (wait for clock stretching)
        ports_gpio_dir(P_I2C0_SCL, PORT_GPIO_IN);
        while(ports_gpio_read(P_I2C0_SCL));
        delay_us(10);
    }

    // Put back into I2C mode
    ports_pinfunc(P_I2C0_SDA, MUX_PA12C_SERCOM2_PAD0);
    ports_pinfunc(P_I2C0_SCL, MUX_PA13C_SERCOM2_PAD1);

    // Note: Some sensors need to be reset to start responding again after fixing SDA
    // Trigger them to reset now if SDA was actually held low
    if(attempts > 0)
        ms5837_reset();

}
