MB3hel/AUVControlBoard/firmware/src/usb.c

/*
 * Copyright 2022 Marcus Behel
 * 
 * This file is part of AUVControlBoard-Firmware.
 * 
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
 */

#include <usb.h>
#include <framework.h>
#include <tusb.h>
#include <limits.h>
#include <string.h>
#include <FreeRTOS.h>


// Special bytes for protocol
#define START_BYTE          253
#define END_BYTE            254
#define ESCAPE_BYTE         255

#if defined(CONTROL_BOARD_V2)
extern RTC_HandleTypeDef hrtc;
#endif


bool usb_initialized = false;


void usb_init(void){
#if defined(CONTROL_BOARD_V1)
    // Set interrupt to highest allowed priority
    NVIC_SetPriority(USB_OTHER_IRQn, configLIBRARY_MAX_SYSCALL_INTERRUPT_PRIORITY);
    NVIC_SetPriority(USB_SOF_HSOF_IRQn, configLIBRARY_MAX_SYSCALL_INTERRUPT_PRIORITY);
    NVIC_SetPriority(USB_TRCPT0_IRQn, configLIBRARY_MAX_SYSCALL_INTERRUPT_PRIORITY);
    NVIC_SetPriority(USB_TRCPT1_IRQn, configLIBRARY_MAX_SYSCALL_INTERRUPT_PRIORITY);

    // Pins configured by generated code
    // Clock config handled by generated code
#elif defined(CONTROL_BOARD_V2)
    // Set interrupt to highest allowed priority
    NVIC_SetPriority(OTG_FS_IRQn, configLIBRARY_MAX_SYSCALL_INTERRUPT_PRIORITY);

    // Pins configured by generated code

    // Enable clock to USB FS peripheral
    __HAL_RCC_USB_OTG_FS_CLK_ENABLE();

    // Disable VBUS sense
    USB_OTG_FS->GCCFG |= USB_OTG_GCCFG_NOVBUSSENS;
    USB_OTG_FS->GCCFG &= ~USB_OTG_GCCFG_VBUSBSEN;
    USB_OTG_FS->GCCFG &= ~USB_OTG_GCCFG_VBUSASEN;
#endif
    usb_initialized = true;
}

void tud_cdc_line_state_cb(uint8_t itf, bool dtr, bool rts){
    (void)rts;

    // Run when line state changes
    // DTR = Data Terminal Ready
    // RTS = Ready to Send
    // DRT usually set when terminal connected

    // sam-ba upload protocol uses a 1200bps "touch" to trigger a reset
    // Handle this as expected
    // Not strictly necessary, but prevents having to press reset button to program
    // 1200bps "touch" means opening the port at 1200bps then closing it again (quickly)
    // Nothing is implemented here with timing. It just boots to bootloader when
    // a 1200bps connection is closed
    if (!dtr && itf == 0) {
        cdc_line_coding_t coding;
        tud_cdc_get_line_coding(&coding);
        if (coding.bit_rate == 1200){
#if defined(CONTROL_BOARD_V1)
            // Special things to reboot to bootloader instead of main program
            // Must match bootloader. Taken from Adafruit/ArduinoCore-samd Reset.cpp
            // THIS IS SPECIFIC TO ITSY BITSY M4!!!
            #define DOUBLE_TAP_MAGIC             0xf01669efUL
            #define BOOT_DOUBLE_TAP_ADDRESS     (HSRAM_ADDR + HSRAM_SIZE - 4)
            volatile unsigned long *a = (unsigned long *)BOOT_DOUBLE_TAP_ADDRESS;
            *a = DOUBLE_TAP_MAGIC;

            // Reset the system now
            NVIC_SystemReset();
            while(1);
#elif defined (CONTROL_BOARD_V2)
            // Reboot by setting a value in a backup register (0)
            // After system reset, if this is set will branch to bootloader
            // This ensures that system is in reset state when entering bootloader
            HAL_PWR_EnableBkUpAccess();
            HAL_RTCEx_BKUPWrite(&hrtc, RTC_BKP_DR0, 0x3851FDEB);
            HAL_PWR_DisableBkUpAccess();
            NVIC_SystemReset();
            while(1);
#endif
        }
    }
}
