MB3hel/AUVControlBoard/firmware/src/debug.c

/*
 * Copyright 2023 Marcus Behel
 * 
 * This file is part of AUVControlBoard-Firmware.
 * 
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
 */

#include <debug.h>
#include <pccomm.h>
#include <string.h>
#include <FreeRTOS.h>
#include <task.h>
#include <led.h>
#include <usb.h>
#include <stdlib.h>
#include <framework.h>


int reset_cause;

void debug_halt(int error_code){
    (void)error_code;

    taskDISABLE_INTERRUPTS();
    led_set(255, 0, 0);
    // Write to persistent memory for after WDT reset
#if defined(CONTROL_BOARD_V1)
    reset_cause_persist = error_code;
#elif defined(CONTROL_BOARD_V2)
    // Note: after full power cycle (backup domain reset) value will be 0x00000000
    //       indicating no error (normal boot / reset cause for reset)
    HAL_PWR_EnableBkUpAccess();
    HAL_RTCEx_BKUPWrite(&hrtc, BKUP_REG_RESETCAUSE, error_code);
    HAL_PWR_DisableBkUpAccess();
#endif
    while(1){
        // Note: nop is here for debugger
        // If Debug build, WDT is disabled and can pause execution here using debugger
        // Else, WDT will trigger a system reset. Error code can be read from last_error
        // on next power on. See RSTWHY command.
        asm("nop");
    }
}

void debug_log(const char *msg){
#ifndef NDEBUG
    if(!usb_initialized)
        return;
    if(xTaskGetSchedulerState() == taskSCHEDULER_NOT_STARTED)
        return;
    
    // Only enable logging for debug builds
    uint8_t buf[PCCOMM_MAX_MSG_LEN];
    buf[0] = 'D';
    buf[1] = 'E';
    buf[2] = 'B';
    buf[3] = 'U';
    buf[4] = 'G';
    unsigned int len = strlen(msg);
    if(len > (PCCOMM_MAX_MSG_LEN - 5))
        len = PCCOMM_MAX_MSG_LEN - 5;
    for(unsigned int i = 0; i < len; ++i)
        buf[5+i] = msg[i];
    pccomm_write(buf, len + 5);
#else
    (void)msg;
#endif
}

void debug_log_data(uint8_t *msg, unsigned int len){
#ifndef NDEBUG
    if(!usb_initialized)
        return;
    if(xTaskGetSchedulerState() == taskSCHEDULER_NOT_STARTED)
        return;
    
    // Only enable logging for debug builds
    uint8_t buf[PCCOMM_MAX_MSG_LEN];
    buf[0] = 'D';
    buf[1] = 'B';
    buf[2] = 'G';
    buf[3] = 'D';
    buf[4] = 'A';
    buf[5] = 'T';
    if(len > (PCCOMM_MAX_MSG_LEN - 6))
        len = PCCOMM_MAX_MSG_LEN - 6;
    for(unsigned int i = 0; i < len; ++i)
        buf[6+i] = msg[i];
    pccomm_write(buf, len + 6);
#else
    (void)msg;
    (void)len;
#endif
}
