MB3hel/AUVControlBoard/iface/sassist.py

#!/usr/bin/env python3

from control_board import ControlBoard, Simulator
import time
import threading


def run(cb: ControlBoard, s: Simulator) -> int:
    # TODO: Remove this once sassist is implemented in simulator
    if s is not None:
        print("NYI in simulator.")
        return 1

    ############################################################################
    # Setup
    ############################################################################
    if s is None:
        # Can only do this if not in simulation
        print("Set motor matrix...", end="")
        mat = ControlBoard.MotorMatrix()
        #        MotorNum    x      y      z    pitch   roll     yaw
        mat.set_row(3,    [ -1,    -1,     0,     0,      0,     +1   ])
        mat.set_row(4,    [ +1,    -1,     0,     0,      0,     -1   ])
        mat.set_row(1,    [ -1,    +1,     0,     0,      0,     -1   ])
        mat.set_row(2,    [ +1,    +1,     0,     0,      0,     +1   ])
        mat.set_row(7,    [  0,     0,    -1,    -1,     -1,      0   ])
        mat.set_row(8,    [  0,     0,    -1,    -1,     +1,      0   ])
        mat.set_row(5,    [  0,     0,    -1,    +1,     -1,      0   ])
        mat.set_row(6,    [  0,     0,    -1,    +1,     +1,      0   ])
        if cb.set_motor_matrix(mat) == ControlBoard.AckError.NONE:
            print("Done.")
        else:
            print("Fail.")
            return 1

        print("Set thruster inversions...", end="")
        if cb.set_tinv([True, True, False, False, True, False, False, True]) == ControlBoard.AckError.NONE:
            print("Done.")
        else:
            print("Fail.")
            return 1

    print("Tuning pitch PID...", end="")
    #                         kP   kI   kD  lim  invert
    if cb.tune_sassist_pitch(0.8, 0.0, 0.0, 0.6, False) != ControlBoard.AckError.NONE:
        print("Fail.")
        return 1
    print("Done.")

    print("Tuning roll PID...", end="")
    #                         kP   kI   kD  lim  invert
    if cb.tune_sassist_roll(0.15, 0.0, 0.0, 0.1, False) != ControlBoard.AckError.NONE:
        print("Fail.")
        return 1
    print("Done.")

    print("Tuning yaw PID...", end="")
    #                       kP   kI   kD  lim  invert
    if cb.tune_sassist_yaw(0.0, 0.0, 0.0, 0.3, False) != ControlBoard.AckError.NONE:
        print("Fail.")
        return 1
    print("Done.")

    print("Tuning depth PID...", end="")
    #                         kP   kI   kD  lim  invert
    if cb.tune_sassist_depth(1.5, 0.0, 0.0, 1.0, False) != ControlBoard.AckError.NONE:
        print("Fail.")
        return 1
    print("Done.")
    
    ############################################################################
    # Sassist mode set
    ############################################################################

    print("Setting sassist mode target...", end="")
    #                   x    y   yaw   p    r    d
    if cb.set_sassist1(0.0, 0.0, 0.0, 0.0, 0.0, -1.5) == ControlBoard.AckError.NONE:
        print("Done.")
    else:
        print("Fail.")
        return 1
    
    t_stop = False
    def do_feed():
        while not t_stop:
            cb.feed_motor_watchdog()
            time.sleep(0.25)
    t = threading.Thread(daemon=True, target=do_feed)
    t.start()
    print("Press enter to stop...", end="")
    input("")
    t_stop = True
    t.join()

    print("Stopping...", end="")
    if cb.set_global(0.0, 0.0, 0.0, 0.0, 0.0, 0.0) == ControlBoard.AckError.NONE:
        print("Done.")
    else:
        print("Fail.")
        return 1


    return 0
