MB3hel/AUVControlBoard/firmware/include/i2c0.h

/**
 * @file i2c0.h
 * 
 * Implementation for i2c0 master
 * 
 * @author Marcus Behel
 */


#pragma once

#include <util.h>


////////////////////////////////////////////////////////////////////////////////////////////////////////////////////////
/// Macros
////////////////////////////////////////////////////////////////////////////////////////////////////////////////////////

// A transaction must not be in progress and bus must be in idle state
#define I2C0_IDLE           ((i2c0_curr_trans == NULL || i2c0_curr_trans->status != I2C_STATUS_BUSY))

////////////////////////////////////////////////////////////////////////////////////////////////////////////////////////
/// Globals
////////////////////////////////////////////////////////////////////////////////////////////////////////////////////////

// Pointer to current transaction
// When I2C0_DONE flag is set, this points to transaction that was just finished
// It will change when i2c0_start is called
extern i2c_trans *i2c0_curr_trans;


////////////////////////////////////////////////////////////////////////////////////////////////////////////////////////
/// Functions
////////////////////////////////////////////////////////////////////////////////////////////////////////////////////////

/**
 * Initialize i2c0 bus
 */
void i2c0_init(void);

/**
 * Start a transaction. Note that a STOP condition  will not occur between write and read phases
 * @param trans The transaction to start. Object pointed to must remain in scope
 *              for duration of the transaction.
 */
bool i2c0_start(i2c_trans *trans);

/**
 * Call from timer IRQ Handler when timeout occurs
 */
void i2c0_timeout(void);
