MB3hel/AUVControlBoard/scripts/controlboard.py

import traceback
import math
from typing import List
import serial
import time
import struct
import threading
from enum import Enum, auto
from crccheck.crc import Crc16CcittFalse as Crc16


debug_prints = True
print_all_msgs = False


class Vector3:
    def __init__(self, x: float = 0.0, y: float = 0.0, z: float = 0.0):
        self.x = x
        self.y = y
        self.z = z

class PRY:
    def __init__(self, pitch: float = 0.0, roll: float = 0.0, yaw: float = 0.0, rad = False):
        self.pitch = pitch
        self.roll = roll
        self.yaw = yaw
        self.rad = False
    
    def to_deg(self):
        if not self.rad:
            return
        self.pitch *= 180.0 / math.pi
        self.roll *= 180.0 / math.pi
        self.yaw *= 180.0 / math.pi
        self.rad = False
    
    def to_rad(self):
        if self.rad:
            return
        self.pitch *= math.pi / 180.0
        self.roll *= math.pi / 180.0
        self.yaw *= math.pi / 180.0
        self.rad = True

class ControlBoard:
    # Communication protocol special values
    START_BYTE = b'\xfd'
    END_BYTE = b'\xfe'
    ESCAPE_BYTE = b'\xff'

    # Modes of operation
    class Mode(Enum):
        UNKNOWN = auto()
        RAW = auto()
        LOCAL = auto()
        GLOBAL = auto()
        SASSIST = auto()

    def __init__(self, port: str):
        self.__ser: serial.Serial = serial.Serial(port)

        # Read any "old" data from the port
        # This could include old messages such as watchdog kills, sensor data, etc
        # From when control board was connected, but not in use
        # Thus messages just sat in buffer
        for i in range(10):
            self.__ser.read_all()
            time.sleep(0.05)

        self.__state_lock = threading.Lock()
        self.__mode: ControlBoard.Mode = ControlBoard.Mode.UNKNOWN
        self.__inverted: List[int] = [2] * 8
        self.__orientation: PRY = PRY()
        self.__grav_vec: Vector3 = Vector3()
        self.__depth: float = 999999
        self.__imu_connected = False
        self.__depth_connected = False
        self.__comm_lost = False
        self.__sstat_query_done = False

        self.__read_thread = threading.Thread(target=self.__read_thread_func, daemon=True)
        self.__read_thread.start()
        self.__feed_thread = threading.Thread(target=self.__feed_thread_func, daemon=True)
        self.__feed_thread.start()


        time.sleep(0.1)


        if not self.set_mode(ControlBoard.Mode.RAW):
            raise Exception("Failed to set initial mode!")
        if not self.set_inverted(False, False, False, False, False, False, False, False):
            raise Exception("Failed to set initial thruster inversions!")
        if not self.refresh_sensor_status():
            raise Exception("Failed to query sensor status!")

    @property
    def comm_lost(self) -> bool:
        return self.__comm_lost
    
    @property
    def imu_connected(self) -> bool:
        with self.__state_lock:
            return self.__imu_connected
    
    @property
    def depth_connected(self) -> bool:
        with self.__state_lock:
            return self.__depth_connected

    def set_mode(self, mode: Mode) -> bool:
        with self.__state_lock:
            if mode == self.__mode:
                # Already in the right mode
                return True

        # Construct and send mode set message
        msg = bytearray()
        msg.extend(b'MODE')
        if mode == ControlBoard.Mode.RAW:
            msg.extend(b'R')
        elif mode == ControlBoard.Mode.LOCAL:
            msg.extend(b'L')
        elif mode == ControlBoard.Mode.GLOBAL:
            msg.extend(b'G')
        elif mode == ControlBoard.Mode.SASSIST:
            msg.extend(b'S')
        else:
            # Not a valid mode to set
            # Note that UNKNOWN mode cannot be set
            return False
        self.__write_msg(bytes(msg))

        # Query mode and wait for it to change (with a timeout)
        self.__write_msg(b'?MODE')
        start_time = time.time()
        while True:
            with self.__state_lock:
                if self.__mode == mode:
                    return True
            if time.time() - start_time > 3.0:
                return False
            time.sleep(0.05)
    
    def get_mode(self) -> Mode:
        with self.__state_lock:
            return self.__mode
    
    def set_inverted(self, i1: bool, i2: bool, i3: bool, i4: bool, i5: bool, i6: bool, i7: bool, i8: bool) -> bool:
        newinv = [
            1 if i1 else 0,
            1 if i2 else 0,
            1 if i3 else 0,
            1 if i4 else 0,
            1 if i5 else 0,
            1 if i6 else 0,
            1 if i7 else 0,
            1 if i8 else 0
        ]

        with self.__state_lock:
            same = True
            for i in range(8):
                if newinv[i] != self.__inverted[i]:
                    same = False
                    break
            if same:
                # Inversions already correct
                return True
        
        # Construct and send message
        msg = bytearray()
        msg.extend(b'TINV')
        for i in range(8):
            msg.append(1 if newinv[i] else 0)
        self.__write_msg(msg)

        # Query inverted and wait for it to change (with a timeout)
        self.__write_msg(b'?TINV')
        start_time = time.time()
        while True:
            if time.time() - start_time > 3.0:
                return False
            with self.__state_lock:
                same = True
                for i in range(8):
                    if newinv[i] != self.__inverted[i]:
                        same = False
                        break
            if same:
                return True
            time.sleep(0.05)
    
    def get_inverted(self) -> List[bool]:
        with self.__state_lock:
            ret: List[bool] = []
            for i in range(8):
                ret.append(self.__inverted[i] == 1)
            return ret
    
    def refresh_sensor_status(self):
        self.__sstat_query_done = False
        self.__write_msg(b'?SSTAT')
        start_time = time.time()
        while True:
            with self.__state_lock:
                if self.__sstat_query_done:
                    return True
            if time.time() - start_time > 3.0:
                return False
            time.sleep(0.05)
    
    def read_sensors(self):
        self.__write_msg(b'?GVEC')
        self.__write_msg(b'?EULER')
        self.__write_msg(b'?DEPTH')

    def set_raw(self, s1: float, s2: float, s3: float, s4: float, s5: float, s6: float, s7: float, s8: float):
        msg = bytearray()
        msg.extend(b'RAW')
        msg.extend(struct.pack("<f", s1))
        msg.extend(struct.pack("<f", s2))
        msg.extend(struct.pack("<f", s3))
        msg.extend(struct.pack("<f", s4))
        msg.extend(struct.pack("<f", s5))
        msg.extend(struct.pack("<f", s6))
        msg.extend(struct.pack("<f", s7))
        msg.extend(struct.pack("<f", s8))
        self.__write_msg(msg)

    def set_local(self, x: float, y: float, z: float, pitch: float, roll: float, yaw: float):
        msg = bytearray()
        msg.extend(b'LOCAL')
        msg.extend(struct.pack("<f", x))
        msg.extend(struct.pack("<f", y))
        msg.extend(struct.pack("<f", z))
        msg.extend(struct.pack("<f", pitch))
        msg.extend(struct.pack("<f", roll))
        msg.extend(struct.pack("<f", yaw))
        self.__write_msg(msg)
    
    def set_global(self, x: float, y: float, z: float, pitch: float, roll: float, yaw: float):
        msg = bytearray()
        msg.extend(b'GLOBAL')
        msg.extend(struct.pack("<f", x))
        msg.extend(struct.pack("<f", y))
        msg.extend(struct.pack("<f", z))
        msg.extend(struct.pack("<f", pitch))
        msg.extend(struct.pack("<f", roll))
        msg.extend(struct.pack("<f", yaw))
        self.__write_msg(msg)

    def tune_pitch_hold(self, kp: float, ki: float, kd: float, kf: float, limit: float):
        msg = bytearray()
        msg.extend(b'TUNEP')
        msg.extend(struct.pack("<f", kp))
        msg.extend(struct.pack("<f", ki))
        msg.extend(struct.pack("<f", kd))
        msg.extend(struct.pack("<f", kf))
        msg.extend(struct.pack("<f", limit))
        self.__write_msg(bytes(msg))
    
    def tune_roll_hold(self, kp: float, ki: float, kd: float, kf: float, limit: float):
        msg = bytearray()
        msg.extend(b'TUNER')
        msg.extend(struct.pack("<f", kp))
        msg.extend(struct.pack("<f", ki))
        msg.extend(struct.pack("<f", kd))
        msg.extend(struct.pack("<f", kf))
        msg.extend(struct.pack("<f", limit))
        self.__write_msg(bytes(msg))

    def tune_depth_hold(self, kp: float, ki: float, kd: float, kf: float, limit: float):
        msg = bytearray()
        msg.extend(b'TUNED')
        msg.extend(struct.pack("<f", kp))
        msg.extend(struct.pack("<f", ki))
        msg.extend(struct.pack("<f", kd))
        msg.extend(struct.pack("<f", kf))
        msg.extend(struct.pack("<f", limit))
        self.__write_msg(bytes(msg))

    def set_sassist(self, x: float, y: float, yaw: float, pitch_target: float, roll_target: float, depth_target: float):
        msg = bytearray()
        msg.extend(b'SASSIST')
        msg.extend(struct.pack("<f", x))
        msg.extend(struct.pack("<f", y))
        msg.extend(struct.pack("<f", yaw))
        msg.extend(struct.pack("<f", pitch_target))
        msg.extend(struct.pack("<f", roll_target))
        msg.extend(struct.pack("<f", depth_target))
        self.__write_msg(bytes(msg))

    def get_gravity_vector(self) -> Vector3:
        return Vector3(self.__grav_vec.x, self.__grav_vec.y, self.__grav_vec.z)

    def get_orientation(self) -> PRY:
        return PRY(self.__orientation.pitch, self.__orientation.roll, 
                self.__orientation.yaw, self.__orientation.rad)

    def get_depth(self) -> float:
        return self.__depth

    def __print_bytes(self, msg: bytes):
        print("[", end="")
        for i in range(len(msg)):
            b = msg[i]
            print("0x{:02X}".format(b), end="")
            if i == len(msg) - 1:
                print("]")
            else:
                print(" ", end="")

    def __handle_read_message(self, msg: bytes):
        # Last two bytes of msg are crc
        # Verify CRC
        read_crc = int.from_bytes(msg[-2:], byteorder='big', signed=False)
        calc_crc = int.from_bytes(Crc16.calcbytes(msg[:-2], byteorder='big'), byteorder='big', signed=False)
        if read_crc != calc_crc:
            # Ignore messages with invalid CRC
            # Log that this occurred
            if debug_prints:
                print("WARNING: Got a message with invalid CRC!")
                print(msg)
                self.__print_bytes(msg)
                print("read_crc = 0x{:04X}".format(read_crc))
                print("calc_crc = 0x{:04X}".format(calc_crc))
                print()
            return

        # Done with crc data
        msg = msg[:-2]

        if print_all_msgs:
            print(msg)

        # Handle the message
        if msg.startswith(b'MODE'):
            # Mode status message
            # Response to mode query

            # Make sure enough data
            if len(msg) < 5:
                return

            # Parse data
            with self.__state_lock:
                if msg[4:5] == b'R':
                    self.__mode = ControlBoard.Mode.RAW
                elif msg[4:5] == b'L':
                    self.__mode = ControlBoard.Mode.LOCAL
                elif msg[4:5] == b'G':
                    self.__mode = ControlBoard.Mode.GLOBAL
                elif msg[4:5] == b'S':
                    self.__mode = ControlBoard.Mode.SASSIST
        elif msg == b'WDGK':
            # Watchdog kill message
            # Received when motor watchdog times out and kills thrusters
            print("WARNING: Control Board Watchdog killed thrusters!")
        elif msg.startswith(b'TINV'):
            # Thruster inversion status message
            # Response to thruster inversion query

            # Make sure enough data
            if len(msg) < 12:
                return

            # Parse data
            with self.__state_lock:
                for i in range(8):
                    if msg[4+i] == 1:
                        self.__inverted[i] = True
                    else:
                        self.__inverted[i] = False
        elif msg.startswith(b'SSTAT'):
            if len(msg) < 7:
                return
            with self.__state_lock:
                self.__imu_connected = msg[5] == 1
                self.__depth_connected = msg[6] == 1
                self.__sstat_query_done = True
        elif msg.startswith(b'EULER'):
            self.__orientation.pitch = struct.unpack_from("<f", buffer=msg, offset=5)[0]
            self.__orientation.roll = struct.unpack_from("<f", buffer=msg, offset=9)[0]
            self.__orientation.yaw = struct.unpack_from("<f", buffer=msg, offset=13)[0]
            self.__orientation.rad = False
        elif msg.startswith(b'GVEC'):
            self.__grav_vec.x = struct.unpack_from("<f", buffer=msg, offset=4)[0]
            self.__grav_vec.y = struct.unpack_from("<f", buffer=msg, offset=8)[0]
            self.__grav_vec.z = struct.unpack_from("<f", buffer=msg, offset=12)[0]
        elif msg.startswith(b'DEPTH'):
            self.__depth = struct.unpack_from("<f", buffer=msg, offset=5)[0]

    def __read_thread_func(self):
        parse_escaped = False
        parse_started = False
        data = bytearray()
        while True:
            c = b''
            try:
                c = self.__ser.read(1)
            except (serial.SerialException, OSError) as e:
                if not self.__comm_lost:
                    print(flush=True)
                    print("READ FAILED! COMMUNICATION WITH CONTROL BOARD LOST!", flush=True)
                    self.__comm_lost = True
            if parse_escaped:
                if c == ControlBoard.START_BYTE or c == ControlBoard.END_BYTE or c == ControlBoard.ESCAPE_BYTE:
                    data.extend(c)
                parse_escaped = False
            else:
                if c == ControlBoard.START_BYTE:
                    if parse_started:
                        data.clear()
                    parse_started = True
                elif c == ControlBoard.END_BYTE and parse_started:
                    parse_started = False
                    self.__handle_read_message(bytes(data))
                    data.clear()
                elif c == ControlBoard.ESCAPE_BYTE and parse_started:
                    parse_escaped = True
                elif parse_started:
                    data.extend(c)

    def __write_msg(self, msg: bytes):
        try:
            self.__ser.write(ControlBoard.START_BYTE)
            for i in range(len(msg)):
                c = msg[i:i+1]
                if c == ControlBoard.START_BYTE or c == ControlBoard.END_BYTE or c == ControlBoard.ESCAPE_BYTE:
                    self.__ser.write(ControlBoard.ESCAPE_BYTE)
                self.__ser.write(c)
            crc = Crc16.calcbytes(msg, byteorder='big')
            crc = crc.replace(ControlBoard.START_BYTE, ControlBoard.ESCAPE_BYTE + ControlBoard.START_BYTE)
            crc = crc.replace(ControlBoard.ESCAPE_BYTE, ControlBoard.ESCAPE_BYTE + ControlBoard.ESCAPE_BYTE)
            crc = crc.replace(ControlBoard.END_BYTE, ControlBoard.ESCAPE_BYTE + ControlBoard.END_BYTE)
            self.__ser.write(crc)
            self.__ser.write(ControlBoard.END_BYTE)
        except (serial.SerialException, OSError) as e:
            if not self.__comm_lost:
                print(flush=True)
                print("WRITE FAILED! COMMUNICATION WITH CONTROL BOARD LOST!", flush=True)
                self.__comm_lost = True

    def __feed_thread_func(self):
        # Feed watchdog every 500ms
        # Watchdog on control board kills thrusters if not fed for 1500ms
        # to ensure motors do not continue running if the computer looses connection
        while True:
            self.__write_msg(b'WDGF')
            time.sleep(0.5)
