MB3hel/AUVControlBoard/(commit log)

2022-08-23 Adding initial motor math
2022-08-23 Finished assembly instructions
2022-08-26 Implemented translation speed translation from world frame to robot frame
2022-08-28 Fix divide by zero bug when calculating pitch and roll
2022-08-28 Implement motor speed deadband in math
2022-08-28 Added thruster config diagram
2022-08-29 Added math doc for motor matrix, dof matrix, and local target vector
2022-08-29 Fix motor speed scaling method to work off overlap not identical rows
2022-08-30 Fixed and documented motor speed math
2022-09-11 Add arduino project to do some simple hardware testing
2022-09-11 Added dotstar led control to hwtest
2022-09-11 Working on c implementation of motor math
2022-09-12 Revert "Not fully functinoal tinyusb lib added to firmware proj"
    This reverts commit 840eb511c766ff6f5ffb830d33d5713fdd493b71.
    [main.c]
2022-09-15 Chaing firmware to ASF4 based
2022-09-17 Have firmware that doesn't crash
    [main.c]
2022-09-19 Added template files for motor pwm
2022-09-19 Made motor_pwm_set arg an array instead of scalar
2022-09-20 Pwm does something...
2022-09-20 WIP afs tcc lite pwm code
2022-09-20 Implemented all thruster pwms using ASF
2022-09-20 Implemented motor watchdog using timer
2022-09-20 Added readme section outline for motor watchdog
2022-09-20 Added RAW mode, LOCAL mode, and motor watchdog documentation to readme
2022-09-21 Updated thruster pinout in prototype assembly guide
2022-09-21 Implement thruster inversion in motor control. Implemented inversion query
2022-09-21 Added support for command to invert motors
    [cmdctrl.c]
2022-09-21 Implemented thruster inversion control in python scripts
2022-09-22 Added initial (non functional) rgbled driver
2022-09-23 Implemented different LED colors for different modes
2022-09-23 Implemented watchdog timer
2022-09-23 Updated prototype assembly images
2022-09-23 Implemented speed range correction (forces -1.0 to 1.0)
    [motor_control.c]
2022-09-24 Fix prototype image labeling
2022-09-24 'Fix' matrix in firmware and add correct inversions in dry run
    [dryrun.py, motor_control.c]
2022-09-24 Fixed motor control init
    [controlboard.py, localmode.py, main.c, motor_control.c]
2022-09-24 Fixed labeling on prototype for real this time
2022-09-27 More work on pccomm flags, general timing flags, and restructuring cmdctrl and motor_control
2022-09-27 Implement motor watchdog and pcccomm crc checking with new interfaces
2022-09-27 Fix typos preventing compilation
    [cmdctrl.c, motor_control.c]
2022-09-27 Fixed an issue where pccomm gave messages with crc and python script ignored mode change
    [controlboard.py, main.c, motor_control.c, pccomm.c]
2022-09-27 Prevent motor watchdog kill message on startup
    [motor_control.c, pccomm.c]
2022-09-28 Added new atstart config with i2c and imported atmel start project with i2c
2022-09-28 Implement i2c transactions
2022-09-28 Add flags for i2c0 sensor callbacks
2022-09-28 Finish outline for i2c flags
2022-09-28 Outline / implement i2c0 flags
2022-09-28 Implemented i2c queueing
2022-10-10 Start outline of bno055 driver
2022-10-10 Add error detection to i2c
    [i2c0.c, util.h]
2022-10-10 Writes and reads of zero bytes are 'performed' to detect errors
    [i2c0.c]
2022-10-10 Added outline code for sending sensor data
2022-10-11 Implement LED blink on sensor error
    [main.c]
2022-10-11 Initial attempt at i2c0 blocking operation
2022-10-12 Fixes to i2c0 state machine and bno055 init
    [bno055.c, i2c0.c]
2022-10-12 Remove dotstar set in i2c0
2022-10-12 Fix i2c0 done flag not set
    [bno055.c, i2c0.c, main.c]
2022-10-12 Debugging i2c nonsense
2022-10-12 Initial work on new i2c stack
2022-10-12 I2C without io_write and io_read
2022-10-13 Add some debug constructs to new i2c driver
2022-10-13 Partial fix to i2c bugs (asf???)
    [i2c0.c, main.c]
2022-10-13 Initial i2c queue implementation
2022-10-13 Fix sensor_error with wdt
    [main.c]
2022-10-13 More work on fixing ASF4
    [i2c0.c, main.c]
2022-10-13 Attempt to fix idle issues
    [main.c]
2022-10-13 Fix flags non volatile
    [flags.h, i2c0.c, main.c]
2022-10-14 Fix more i2c asf bugs
    [bno055.c, i2c0.c]
2022-10-15 Initial attept at acquiring sensor data
2022-10-15 Initial work on parsing sensor data
2022-10-15 Fix crc escaping when firmware sends message to pc
    [controlboard.py, pccomm.c, sensortest.py]
2022-10-15 Fix gravity vector parsing
    [cmdctrl.c, controlboard.py]
2022-10-15 Reduce send rate of sensor data and increased bno055 delays
2022-10-15 Add global mode led color
2022-10-15 Add command to reset control board
    [cmdctrl.c, reset.py, timers.c, timers.h]
2022-10-15 Fix global mode message interpretation
    [cmdctrl.c, main.c, motor_control.c]
2022-10-15 Reenable mode indicator LED
2022-10-15 Kindof set axis config correctly
    [bno055.c, bno055.h, sensortest.py]
2022-10-16 Add device pinout
2022-10-16 initial work on asf i2c lite driver I2C stack
2022-10-17 Implemented IRQ handler for custom i2c stack
2022-10-17 Fix byte order in transmit stage of i2c stack
    [i2c0.c, main.c]
2022-10-17 I2C sets result correctly for empty transaction
    [i2c0.c]
2022-10-17 Handling empty transactions differently (i2c)
2022-10-17 Interrupts for i2c0 are actually enabled
2022-10-17 Using one irq handler for all irqs in i2c0
2022-10-23 Fixed bugs in i2c0 stack
    [bno055.c, i2c0.c, main.c]
2022-10-23 Fix read NACK issue with i2c
    [i2c0.c]
2022-10-23 Fix some i2c read bugs
    [bno055.c, controlboard.py, sensortest.py]
2022-10-23 Add i2c0 timeout and dotstar used to show timeout events
2022-10-23 I2C0 is reset if too many timeouts in a row
    [bno055.c, i2c0.c]
2022-10-23 Massive reduction of i2c0 timeout
2022-10-24 Axis system is shown on prototype images
2022-10-24 Using euler angles to directly get pitch, roll, yaw
2022-10-24 Notes on prototype assembly
2022-10-24 Trying to get a second timer working
2022-10-26 Starting work on timers
2022-10-26 Fixed timers
2022-10-26 Fixed tinyusb init to not require asf
    [clocks.c, pccomm.c, ports.c, ports.h]
2022-10-27 Move usb pin config to correct spot
    [pccomm.c, ports.c]
2022-10-27 Reboot to bootloader triggering works
    [usb.c]
2022-10-27 Replace tabs with spaces in usb.c
    [usb.c]
2022-10-27 Remove traces of atmel start from project
2022-10-27 Implemented thruster pwm with timers
2022-10-27 Implement test messages for pwm
2022-10-28 Adding back motor control math
2022-10-28 Re-enabled thruster inversions in dryrun script
2022-10-28 Added initial port of i2c0 code
2022-10-28 Removed overly complicated i2c stack
2022-10-28 Implemented a simplified i2c0 stack
2022-10-28 Add some comments showing inteneded use of i2c0
2022-10-29 A lot of i2c0 fixes
    [i2c0.c, main.c, ports.c, ports.h]
2022-10-29 Added i2c transactions and outlined bno055
2022-10-29 Implemented i2c fixes, bno055 init, and bno055 delay
    [bno055.c, bno055.h, flags.h, i2c0.c, main.c, timers.c, timers.h]
2022-10-29 More explicit settings in i2c0
2022-10-29 I2c debug code
2022-10-29 i2c and wdt bugfixes
    [i2c0.c, main.c, timers.h, usb.c]
2022-10-29 Trying to track down TC0 CC1 issue
    [timers.c]
2022-10-29 Fix some timing issues
    [flags.h, i2c0.c, i2c0.h, main.c, timers.c, timers.h]
2022-10-29 Timer work
2022-10-29 Switch to MFRQ mode for timers
2022-10-30 Timeout is closer to working for i2c0
2022-10-30 Handle i2c0 bus re-enable properly
2022-10-31 Adapted i2c0 transaction starting to support multiple sensors
2022-10-31 Work on initial depth sensor state machine
2022-10-31 Implement most of depth sensor state machine
2022-10-31 Add todo to fix depth sensor
2022-10-31 Implement MS5837 sensor validation
2022-10-31 TEMP testing setup for depth sensor validation
2022-10-31 Added option to stop after write with i2c transaction
2022-11-01 Add depth sensor calculations
2022-11-01 Fix depth sensor indices
    [ms5837.c]
2022-11-01 Fix case fallthrough in depth sensor driver
    [ms5837.c]
2022-11-01 Fixed starting i2c transactions with multiple sensors
    [i2c0.c, main.c]
2022-11-02 Depth sensor is reset if SDA held low to ensure sensor keeps responding
    [ms5837.c, ms5837.h, ports.c]
2022-11-02 Reset depth sensor properly (probably) this time
    [ms5837.c, ports.c]
2022-11-04 i2c0 waits for bus to be idle before starting transactions
2022-11-05 Enabled mode led
2022-11-09 Very temporary imu not connected detection in global mode
2022-11-09 Revert "Add ERRIMU message handling to python scripts"
    This reverts commit 7e78c0676e8223195432c65ed03c83a068261c66.
    [controlboard.py]
2022-11-09 Revert "Very temporary imu not connected detection in global mode"
    This reverts commit c1673b256c07a96e632b97c6fa0c241d64735f42.
    [cmdctrl.c]
2022-11-09 Add sensor status query
2022-11-10 Enabled reading sensor data
2022-11-10 Added some i2c0 synchronization that was missing
    [i2c0.c, main.c]
2022-11-10 Tracking down bus state getting stuck
    [main.c, util.c, util.h]
2022-11-10 Fix i2c0 manager bug that could cause some sensors to stop working
    [i2c0.c, i2c0.h, main.c]
2022-11-10 Remove debug prints
2022-11-10 Check sensors less often if init fails
    [bno055.c, ms5837.c]
2022-11-10 Sensors reset state machines if too many i2c errors
    [bno055.c, ms5837.c]
2022-11-10 Sensor status determiend from last data time
2022-11-10 Implemented PID controller
2022-11-11 Implemented stability assist commands in firmware
    [cmdctrl.c, motor_control.c, motor_control.h]
2022-11-11 Implemented depth sensor read from pc
2022-11-11 Implemented depth sensor reading from python scripts
2022-11-11 Implemented command parsing in firmware for PID tune
2022-11-11 Implement delayed speed set for stability assist mode in firmware
    [cmdctrl.c]
2022-11-11 Implemented PID tune and sassist mode set in python scripts
2022-11-11 Add some debug logging to track down i2c issue
    [i2c0.c, main.c]
2022-11-11 Added even more debug logging to fix i2c sensor issue
    [bno055.c, main.c, ms5837.c, read_debug.py, timers.c]
2022-11-12 Flag trace for debug
2022-11-12 Hacky / temporary workaround to sensor death
    [bno055.c, bno055.h, flags.h, main.c, ms5837.c, ms5837.h, ports.c]
2022-11-12 Changed method of detecting sensors stuck in delay state
    [bno055.c, ms5837.c]
2022-11-15 Initial blink code working on STM32
2022-11-16 Minor tweaks to stm32 proj
2022-11-16 Implement more proper abstraction for led and delay subsystems
2022-11-16 Remove redundant comment from hardware v1 assembly instructions.
2022-11-19 Moved some usb configuration to STM32CubeMX for v2
2022-11-20 Added comment about pin config for v2
2022-11-20 Change USB name for device
2022-11-20 Implemented rgb led in v1 firmware
2022-11-28 Use freertos critial section for led v1
2022-11-29 Add PWM and I2C pins to v2 generator proj
2022-11-29 Added PWM control of RGB LED to v2 code
2022-11-30 Fix RGB LED on v2
    [led.c]
2022-12-06 Fix usb init on v2
    [main.c]
2022-12-06 Reorganize threads and usb code
2022-12-07 Add wiring diagram for v1 hardware
2022-12-07 Implement thruster pwm for v1
    - Added thruster pin mappings in MCC
    - Added TCC peripherals in MCC
    - Implemented thruster functions (for v1)
    - Removed LED blink thread
    - Removed red led for v1
2022-12-07 Added thruster pwm code for v2
    - Updated STM32CubeMX project
    - Added thruster.c implementation for v2
2022-12-07 Fix THR5 not working on v2
    [ControlBoard_v2.ioc]
2022-12-07 Updates to hardware docs
    - Improved v1 component list and formatting
    - Improved v2 component list and formatting
    - Added v2 wiring diagram
2022-12-07 Fixed wire length on v2 wire diagram
2022-12-07 Add RGB LED info for v2
2022-12-07 Added v2 assembly to docs
2022-12-08 Simplified led code (only RGB led)
2022-12-08 Start on program restructure for RTOS threads
2022-12-08 Added interface script & debug TinyUSB read issues
    [cmdctrl.c, control_board.py, pccomm.c, threads.c]
2022-12-08 Fix read raw command in firmware
    [cmdctrl.c, threads.c]
2022-12-08 Made v2 led colors visually match v1
2022-12-08 Add proper mode LED control in cmdctrl
2022-12-08 Fix initial LED color in firmware
    [cmdctrl.c]
2022-12-08 Fixed stack overflow after a few usb messages
    [threads.c]
2022-12-08 Error handlers disable interrupt and set led color
    [irq_handlers.c, main.c]
2022-12-08 Fix deceptive error message on uart crash (iface)
    [control_board.py]
2022-12-08 Add basic motor control abstraction
2022-12-08 Implement thruster inversion in iface script
2022-12-08 Fixed iface script not escaping crc
    [control_board.py]
2022-12-10 Reorganize so mutex can be added to motor control
2022-12-10 Add mutex to motor control
2022-12-10 Motor watchdog fully implemented
2022-12-10 Implement motor watchdog feed command
2022-12-10 Fix destructor exceptions in iface script
    [control_board.py]
2022-12-10 Add DoF matrix API to motor_control - Implemented function to set dof matrix rows - Outlined function to update calculated values after DoF matrix update
2022-12-10 Remove useless nop from motor_control
2022-12-10 Add commands to set motor matrix data in firmware
2022-12-13 Implement motor matrix set in iface script
2022-12-13 Implement motor watchdog status message
2022-12-13 Add all currently implemented messages to docs page
2022-12-14 Initial i2c implementation for v1
2022-12-14 Add i2c driver for v2 in generator proj
2022-12-14 Enable interrupts in stm32cube project
2022-12-14 Implement I2C for v2 (initial implementation)
2022-12-14 Fix give semaphore in v1 i2c (uses ISR func)
    [i2c.c]
2022-12-14 Fix semaphore gives in i2c callbacks (uses ISR funcs)
    [i2c.c]
2022-12-15 Add v1 I2C IRQ handlers
2022-12-15 Add IMU test code to test I2C
2022-12-15 Temp (debug) changes to v2 I2C
2022-12-17 Fix v2 i2c implementation
    [i2c.c]
2022-12-18 Implement BNO055 driver read
2022-12-18 Implement IMU read in task
2022-12-18 Implemented i2c retires
2022-12-18 Added sensor status query to firmware
2022-12-18 Add sensor status query to interface script
2022-12-19 Add sensor status query to docs
2022-12-19 Implement IMU remap set in firmware
2022-12-21 Invalid gravity vectors no longer deadlock firmware
    [app.h, cmdctrl.c, i2c.c, motor_control.c]
2022-12-22 Attempts to debug i2c issues with v2
    [cmdctrl.c, i2c.c]
2022-12-22 Fix missing "void" in cmdctrl func
    [cmdctrl.c, cmdctrl.h]
2022-12-22 v2 I2C code fixes sda being held low
    [i2c.c]
2022-12-22 Implement fix sda low for v1
    [i2c.c]
2022-12-22 Fix macro typo in app.c
    [app.c, app.h]
2022-12-22 v1 sda low fix no longer breaks i2c
    [i2c.c]
2022-12-22 Write global mode command docs (and imu config)
2022-12-22 Add IMU axis config note about zero data
2022-12-22 Implement periodic speed reapply and sensor data read timer in firmware
2022-12-22 Increase timer task stack size
2022-12-23 Fix euler yaw direction
    [bno055.c]
2022-12-23 Remove euler yaw fix (shouldn't need)
    [bno055.c]
2022-12-23 BNO055 read is INVALID_CMD if sensor not ready
2022-12-27 Added api for ms5837 driver
2022-12-27 Added depth sensor task and commented steps of driver
2022-12-27 Implement ms5837 driver functions
2022-12-27 Add depth sensor info
2022-12-28 Implement depth sensor read in firmware
2022-12-28 Made rtos objects static in motor_control
2023-01-04 Fix quaternion multiply if dest is same as input
    [angles.c]
2023-01-05 Fix accumulated euler angles in firmware
    [bno055.c, bno055.h, cmdctrl.c, control_board.py]
2023-01-06 Implemented stability assist mode math in firmware
    [motor_control.c, motor_control.h]
2023-01-07 Documented stability assist tune command
    [control_board.py]
2023-01-08 Fix feed-forward in sassist pids in firmware
    [motor_control.c]
2023-01-08 Implement device serial number usb descriptor for v2
2023-01-09 Spacing fix in dry run script
    [dryrun.py]
2023-01-09 Fix depth sensor prom data array bounds
    [ms5837.c]
2023-01-09 Add comment on depth sensor prom data size
2023-01-11 Rename dryrun script to motor_test
2023-01-11 Feed motor watchdog killing local and global test scripts
2023-01-11 Fix accumulation drift when quaternion does not change
    [bno055.c]
2023-01-11 Add sensor data display script
2023-01-12 Fix motor numbering in motor_test.py
    [motor_test.py]
2023-01-14 Fix invalid depth sensor status
    [cmdctrl.c, control_board.py, globalmode.py, localmode.py, sensordata.py]
2023-01-15 Add stability assist mode test script
    [sassist.py]
2023-01-15 Increase memory allocation
    While this is not strictly necessary, it rules out stack overflow occurring while testing some strange bugs
    [app.h]
2023-01-15 Fix timeout arguments being non-optional in some iface functions
    [control_board.py]
2023-01-15 Add timeout for acquiring i2c mutex in i2c_perform (v1 and v2) in firmware
2023-01-15 Fix i2c failure holding mutex forever in v1 firmware
    [i2c.c]
2023-01-15 Made i2c timeout more readable in v2 fw
2023-01-15 Fix i2c mutex not given before return in v2 firmware
    [i2c.c]
2023-01-15 Add partial fix for v1 i2c bad hardware state
    [i2c.c]
2023-01-16 Fixed v1 I2C stuck in busy state
    [i2c.c]
2023-01-16 Add signal timeout to v1 i2c
2023-01-16 Add done signal timeouts in v2 i2c firmware
2023-01-16 Revert "Add done signal timeouts in v2 i2c firmware"
    This reverts commit 82e7f0e53d532eec1832439310312d580113430f.
    [i2c.c]
2023-01-18 Add done flag timeouts for v2 i2c
2023-01-18 V2 i2c can recover from hotplug noise
    [i2c.c]
2023-01-18 Increase time after switching to fusion mode
2023-01-26 Firmware does not send depth sensor data if depth sensor is not ready
2023-01-27 Fix i2c hotplug on v1
    [i2c.c]
2023-01-27 Add semaphore hotplug fix to v2 i2c code
    [i2c.c]
2023-01-27 Implement reset function in iface script
    [control_board.py, reset.py]
2023-01-27 Implement watchdog timer in v2
2023-01-27 Implement reset to bootloader via usb
    [ControlBoard_v2.ioc, main.c, usb.c]
2023-01-27 Reorganize bootloader reboot code for v2
    [framework.h, main.c]
2023-01-27 Fixed v1 boot to bootloader code
    [usb.c]
2023-01-27 Moved reboot to bootloader script
    [reboot_bootloader.py]
2023-01-27 Flash script config is case insensitive
2023-01-27 Made reboot bootloader script executable
    [reboot_bootloader.py]
2023-01-30 Fix debug messages being cut short
    [debug.c]
2023-01-30 Fix periodic IMU read in iface script
    [control_board.py, sensordata.py]
2023-01-31 Fix global mode rotation matrix direction
    [motor_control.c]
2023-02-06 Fix minor issue with msg startswith macro
    [cmdctrl.c]
2023-02-07 Implement crude stability assist mode
    [motor_control.c]
2023-02-08 Fix "may be uninitialized" warnings in matrix c library
    [matrix.c]
2023-02-08 Clarify some comments in motor_control.c
2023-02-08 Add comment about PID control variables
2023-02-08 Fix typo in cmdctrl comment
    [cmdctrl.c]
2023-02-08 Fix sassist euler in radians
    [motor_control.c]
2023-02-08 Fix sassit euler in radians for real
    [motor_control.c]
2023-02-08 Fix wrong comparison in global mode gvec check
    [motor_control.c]
2023-02-10 Fix invalid gravity vector norm check
    [motor_control.c]
2023-02-10 Fix confusing use of global and local in global mode math
    [motor_control.c]
2023-02-10 Fix parse started buf in firmware
    [pccomm.c]
2023-02-11 invalid crc with debug enabled prints message
2023-02-11 Maybe fix socket issue with gamepad scripts
    [gamepad_global.py, gamepad_local.py]
2023-02-11 Allow sensordata script in simulator
2023-02-11 Fixed pid directions for sassist
    [motor_control.c]
2023-02-12 Fix gimbal lock euler conversion in firmware
    [angles.c]
2023-02-12 Fix euler conversion in iface script
    [control_board.py]
2023-02-14 Debug data messages printed as byte strings
2023-02-17 Fix euler convention in firmware
    [angles.c, angles.h]
2023-02-19 Fix debug log before rtos startup
    [debug.c, motor_control.c, thruster.c, usb.c, usb.h]
2023-02-19 Remove PID feed-forward gain
2023-02-19 Remove kF from PID in iface
2023-02-19 Add invert control to PID in firmware
    [cmdctrl.c, motor_control.c, motor_control.h, pid.c, pid.h]
2023-02-19 Remove kF and add invert to iface
    [control_board.py, sassist.py]
2023-02-19 Update docs for pid tuning
2023-02-19 Add depth hold to firmware motor_control
2023-02-20 Fix unhandled pwm set failure on v1
    [main.c, thruster.c]
2023-02-24 Switch global mode math to quaternions
2023-03-31 Fix deadlock if IMU data is zeros
    [cmdctrl.c, debug.c, motor_control.c]
2023-04-01 Fix v2 reboot to bootloader in release builds
    [framework.h]
2023-04-01 Add reset cause log for v2
    [cmdctrl.c, control_board.py, debug.c, debug.h, framework.h, whyreset.py]
2023-04-01 Implement reset cause in v1
    [cmdctrl.c, framework.h]
2023-04-01 Implement WDT reset cause for v1
    [cmdctrl.c, debug.h, framework.h]
2023-04-01 Fix v1 reset command showing as wdt reset cause
    [usb.c, wdt.c]
2023-04-08 Added initial pcb work
    [PCBv2.1.kicad_pcb, PCBv2.1.kicad_sch]
2023-04-08 Add power supply and leds to pcb
    [PCBv2.1.kicad_sch]
2023-04-08 Labeled all pins in pcb schematic
    [PCBv2.1.kicad_sch]
2023-04-08 Add usb application note for stm32
2023-04-08 Wired IMU in pcb schematic
    [PCBv2.1.kicad_sch]
2023-04-08 Add headers to pcb schematic
    [PCBv2.1.kicad_sch]
2023-04-08 Finished pcb schematic
    [PCBv2.1.kicad_sch]
2023-04-08 Add more part numbers
    [PCBv2.1.kicad_sch]
2023-04-08 Add specific USB-C connector and resistor part numbers to pcb schematic
    [PCBv2.1.kicad_pcb, PCBv2.1.kicad_sch]
2023-04-08 Add footprints for resistors
    [PCBv2.1.kicad_sch]
2023-04-08 Add button part numbers for pcb
    [PCBv2.1.kicad_sch]
2023-04-08 Add crystal part numbers to pcb
    [PCBv2.1.kicad_sch]
2023-04-08 Remove old components from pcb
    [PCBv2.1.kicad_pcb]
