MB3hel/AUVControlBoard/(notices)

Notices in the files:
firmware/src/usb.c:
General Public License as published by the Free Software Foundation, either version 3 of the License, or (at your
